hectorsvill/bb1-balance-bot-1/firmware/README.md

# Firmware

| Folder | What it is |
|---|---|
| `bb1/` | The main firmware, grown one step at a time (see `docs/FIRMWARE_PLAN.md`) |
| `motor_test/`, `imu_test/`, `tof_test/` | Bring-up tests, kept as they were |
| `uf2/` | Prebuilt files to drag onto the Pico |

## RAM (firmware 3.3, 2026-10-28)

The RP2040 has 256 KB of main RAM. Static RAM (fixed at compile time) is 218.0 KB (was 226.0 KB in 3.2); what's left, about 44 KB, is the heap (Strings, web requests, Wi-Fi connections). Where the static part goes:

| What | Bytes | Whose |
|---|---|---|
| Log ring buffer (`telemetry.h`): 2000 records x 72 bytes = the last 10 s | 144,000 | ours |
| lwIP TCP/IP stack: packet pool 36.8 KB, its own heap 16 KB, connections, DNS, DHCP | 58,400 | core (prebuilt, "IPv4 Only" is already its smallest setting) |
| Code that must run from RAM, malloc, locale | 6,000 | core |
| CYW43 Wi-Fi chip driver and `WiFi` | 3,200 | core |
| USB serial, other core variables | 5,500 | core |
| Everything else of ours (`server`, settings, controller state) | 600 | ours |

- **3.3:** the buffer no longer stores the tick number (record n in the buffer is always tick n, so `logGet()` puts it back). 76 -> 72 bytes a record, 8,000 bytes saved, the CSV is exactly the same.
- The log buffer is the only big thing we own. The next step down is a shorter history (`LOG_SECONDS` in `config.h`): 8 s saves 28.8 KB more, 6 s saves 57.6 KB. The cost: a recorder (page, `logger.py`, `drive_test.py`) that doesn't ask for `/log` for longer than that loses records (they poll every 0.25 s; the worst Wi-Fi stall seen is 2.5 s). Not changed yet: a choice for us to make.
- Big stack buffers on core 0 (`/state` 1.4 KB, `/log` 2 KB) are not in these numbers: core 0 has its own 4 KB stack. Keep new ones small.
- Check **Heap free** in the Pico memory panel (or `GET /sys`) stays over 20 KB.

## Firmware updates over Wi-Fi (`ota.h`, 2026-10-27, flashed)

`POST /update` takes a new firmware over Wi-Fi; `tools/flash.py --ota --execute` sends it (without `--execute`, flash.py only prints a JSON plan). Lying down and disarmed only (BB1 checks), password `BB1_OTA_PASSWORD` in `secrets.h`. Needs Flash Size "Sketch: 1MB, FS: 1MB" (`flash.py` and CI use it; the first one goes on over USB). How it works and what to do when it fails: `docs/FLASHING.md`, "Flashing over Wi-Fi".

`version.h` says which firmware this is: `FIRMWARE_VERSION` (bump it by hand per firmware change) and `BB1_BUILD_ID` (written by `flash.py` into the gitignored `build_id.h`). Shown in `/sys`, `/api`, the main page and the log files.

## bb1, milestone 2: driving (`drive.h`, 2026-10-25; changes of 2026-10-26 flashed)

BB1 drives by moving the **targets** of the speed loop and heading hold, never by sending PWM straight to the wheels, so the balance loop stays in charge (quad picture: angle mode with position hold, and the sticks move the hold point).

- Speed: the speed loop now works on `speed - asked speed` and `position - target position`. While driving, the target position rides with the wheels; when BB1 comes to a stop it holds that spot (and that heading). Lean forward to speed up, back to slow down: the loop works it out.
- Turn: the heading hold's target (right-minus-left wheel turns) slides at the asked turn rate, and `DRIVE_TURN_FF` (15 PWM per turn/s) adds the steering at once, like Betaflight feedforward, so the hold doesn't have to lag first. Limited to ±100 PWM (`TURN_HOLD_MAX_PWM`; ±40 before firmware 3.7). (45 was tried 2026-10-26 from a misread log and overshot.) **Known bug:** the logged wheel speed reads 3.3x low (CHANGELOG 2026-10-26).
- Speed feedforward, setting **`dff`** (PWM per turn/s of speed target, default 60, /tune box **Drive FF (dff)**, serial `dff 60`, saved in flash, settings layout v5): added straight to both wheels. Why (first drive log, 2026-10-25): these motors are speed knobs, holding 1 turn/s takes about 105 PWM, and without feedforward the angle I term carried all of it (I about +100 going forward). Reversing, I had to unwind from +100 while the wheels kept rolling forward, BB1 tipped back past 9 deg, hit the cap and fell backward: every fall in that log. Feedforward takes most of that load off I.
- Both ramp (speed at setting **`dacc`**, default 3 turns/s per s since 2026-10-29, was the constant `DRIVE_ACCEL`; turn at 6, 2 before firmware 3.7): a full jab can't kick it over. Limits ±3 turns/s speed (`DRIVE_MAX_SPEED`, 1.0 before firmware 3.6) and ±5 turns/s turn (`DRIVE_MAX_TURN`, 1.0 before 3.7; one spin = 4.49); the lift detector trips at 4 turns/s off the target. Slowing down is never slower than 3 turns/s per s (`DRIVE_STOP_ACCEL_MIN`).
- Failsafe: a command lasts 500 ms (`DRIVE_HOLD_MS`, or `ms=` up to 3000). Not sent again = ramp to a stop and keep balancing. Disarm, fall or a new arm clears it. While turning, the heading target never gets more than 0.25 wheel turns (about 18 deg) ahead of the wheels (`DRIVE_MAX_LAG`; was 1.0, which made BB1 swing 35-90 deg after a turn and roll 2-3 turns after letting go, floor test 1).
- Each axis only lets go of its own hold (2026-10-26): turning on the spot keeps the position hold (it rolled back 1-2 wheel turns per turn test), and driving straight keeps the full heading hold (the 0.25-turn lag clamp applies only while turning).
- `driveCommand()` in `drive.h` is the one place that clamps a command and hands it to core 1, for both `POST /drive` and serial `drive`; non-numbers (`nan`) are refused (HTTP 400). An encoder fault also ends the command already running.
- **Exact-angle spins (firmware 3.10):** `POST /spin deg=90 rate=2`, serial `spin 90 [rate]`, page Spin buttons. `spinCommand()` clamps and hands it over like `driveCommand()`; `spinUpdate()` (core 1) subtracts the gyro yaw (`angle.h` `yawRate`, right +) from the angle still to go every tick and starts the turn ramp-down when that equals the stopping angle (yaw rate x ramp time / 2). The gyro, not the wheels: they scrub in a spin (gyro / encoder yaw = 0.83, runs 189-190). Any `/drive`, a stop, a disarm, an encoder fault or a timeout ends it. Logged as `spin_left` (log format 14), in a 2-byte padding gap of `LogData`, so the record stays 72 bytes (a `static_assert` guards it).
- Drive speed I, setting **`sdi`** (default 4 since the 2026-10-26 evening drive tests; was 2): while driving, degrees of lean added per second per turn/s it is slower than asked, so it can't get stuck short of the asked speed (it did going forward with the speed loop's P alone). Capped by `SPEED_SHIFT_MAX`, fades out after a stop.
- **Speed loop mode `smode`** (2026-10-26): 0 = the speed loop moves the setpoint (sp, si, sdi). 1 = wheel speed loop: `wsp` x speed error + `wsi` x position error straight to the PWM (±100), the balance-car layout, for use with a lower ki. Why: with smode 0 the angle I term holds the wheel speed and the speed loop can't reach it (BB1 rolled backward with no command).
- **I-term relax `irelax`** (2026-10-26, default 0.5 s, 0 = off): when a drive command has ramped down to a stop, the angle loop's I term decays toward 0 with that time constant for 2 x irelax (`drive.h` starts it, `control.h` does it, flag 64 in the log). Why: after driving the I term kept -4 to -9 PWM and rolled BB1 slowly backward, out of the box in unattended runs. Like Betaflight's I-term relax. Driving again cancels it. Live on /tune, serial `irelax N`, `/state`, saved in flash (settings layout v8; older saves get the default).
- **Fast drive step 1 (firmware 3.4, 2026-10-28): `aff`, `dacc`, `lmax`**, all live on /tune and serial, saved in flash (settings layout v9; older saves load with the defaults), in `/state` gains and the `# gains_ver` line (`accel_ff`, `drive_accel`, `lean_max`). Defaults = the old behavior. Why: at 0.5 turns/s on wood BB1 used about 24 of 200 PWM and leaned under 1 deg; the lean only came after a speed error built up, so it lagged and fell short. To accelerate at a, a balancing robot must lean atan(a/g): 1 turn/s² = 0.178 m/s² = about 1.04 deg.
  - `aff` (deg per turn/s², default 0 = off, max 5): acceleration lean feedforward. `drive.h` works out the ramped target's acceleration each tick (+dacc, -dacc or 0), smooths `aff x accel` over 0.05 s (`ACCEL_FF_SMOOTH_S`), and `control.h` adds it to the speed loop's setpoint shift (smode 0 only). Like Betaflight feedforward: lean before the error exists.
  - `dacc` (turns/s per s, default 1, 0.1-6): the speed ramp. The turn ramp is unchanged.
  - `lmax` (deg, default 6, 6-15): the clamp on the setpoint shift (and on the `sdi` lean) while a speed target is set or ramping down. Standing it is `SPEED_SHIFT_MAX` (6). Raising the clamp is instant (it only allows more); lowering eases at 10 deg/s (`LEAN_LIMIT_EASE_DPS`), so the setpoint never jumps (a 4 deg jump would be a 72 PWM kick at kp 18).
  - `DRIVE_MAX_SPEED` stays 1.0 (step 2 below).
- **Fast drive step 2 (firmware 3.6, 2026-10-29): top speed 3.0 turns/s** (0.53 m/s; `DRIVE_MAX_SPEED`, was 1.0; turn stays 1.0). Why it is safe to try: at 1.0 on wood the PWM peaked at 102-106 of cap 200, never saturated, and steady driving takes about dff 25 PWM per turn/s + deadband 10, so 3.0 needs about 85 PWM before balancing. In the same change:
  - **Log format 12:** `drive_speed`, `drive_turn`, `drive_speed_now`, `drive_turn_now` are int8 in 1/40 turns/s (`DRIVE_LOG_STEPS`, telemetry.h; max 3.17, steps 0.025) instead of hundredths (max 1.27). No RAM cost; int16 would have been 8 KB. The CSV still says turns/s (3 decimals). Flag 8 (saturated) now also counts the PID + feedforward + deadband at the cap.
  - **Lift detector** compares each wheel with its drive target (`control.h`): standing still it is the old check, driving fast it doesn't trip.
  - **Speed guards** (`drive.h` `speedCeiling()`): the feedforward `dff x speed` never takes more than `cap - DRIVE_PWM_RESERVE` (80) PWM, and if the motor PWM sits at the cap more than 0.2 s while driving (`DRIVE_SAT_BACKOFF_S`), the speed target backs off at 3 turns/s per s and climbs back at `dacc`. Why: a balance loop at the cap can't catch a fall. `/state` `speed_now` shows the result.
  - **Stops:** slowing down is never slower than `DRIVE_STOP_ACCEL_MIN` (3 turns/s per s), so a run-out command or `/drive/stop` from 3 turns/s stops in 1 s (about 0.27 m) even at a low `dacc`.
  - The `# drive_max_speed` header line also gives `drive_pwm_reserve`, `drive_sat_backoff_s`, `drive_stop_accel_min`, `lift_tps`, `lift_ms`. `/api` version 6. The page's Max speed slider is in turns/s (default 1.0, up to 3.0).
  - Tests: wood, fwd-back-100 forward 1.00 / back 0.77, fwd-back-150 back 1.42, PWM peak 135, no saturation (runs 177, 179). Carpet stalls forward (0.06-0.13 of 1.0) on the 2 Hz balance rocking (runs 175-176).
- **Fast spins (firmware 3.7, 2026-10-31): turn 5.0 turns/s**, a full 360 on the spot in about 1 s (it was 4.5 s at 1.0). In the same change:
  - **Deadband per wheel** (`control.h` `wheelPwm()`, called in `bb1.ino`): the deadband is added to each wheel after the steering, in the direction that wheel turns. Before, it was added once to the shared balance output, which crosses 0 about 11 times a second, so both wheels jumped by 2 x deadband each time and the slow wheel of a turn stuck and slipped: the turn jitter (run 178). It also steadied standing (pitch std 0.60 -> 0.23 deg).
  - **Steering** up to ±100 PWM (`TURN_HOLD_MAX_PWM`, was 40), turn ramp 6 turns/s per s (`DRIVE_TURN_ACCEL`, was 2).
  - **Pitch while turning** (`angle.h`): the chip sits about 2.5 deg off level, so it sees part of the yaw rate as pitch rate: `pitchRate += GYRO_YAW_TO_PITCH (0.043) x gz`. Without it, a turn-2 spin read 6 deg/s of fake tilt and BB1 raced backward (run 181). A gyro-only mode above 120 deg/s and an accelerometer centripetal correction were tried and taken out: the correction was fitted on a run where BB1 really tilted and made long left spins roll back (run 186); the accelerometer moves only 0-1 deg in a spin.
  - **Log format 13:** `drive_turn` and `drive_turn_now` in 1/20 turns/s (`DRIVE_TURN_LOG_STEPS`, max 6.35). `/api` version 7. Tests: `drive_test.py spin-100` ... `spin-450` (runs 182-185, all pass).
- **Trim learn `tl` (firmware 3.5, 2026-10-29; default 1.0, 0-5, 0 = off):** the fix for the backward creep after stops. Why: on wood BB1 really balances about +1.3 deg forward of `trim`; the speed loop's position term (si) would cancel that, but `drive.h` moves its hold point to the wheels at every stop, so after each command BB1 got the lean it needs only from `-sp x speed`, by rolling backward at 0.2-0.4 turns/s. `control.h` now keeps `balance.trimLearned` (deg, ±3 at most, `TRIM_LEARN_MAX`): in smode 0, while armed and standing still (both ramps at 0, not stopping, the coast and I relax after a stop over, no step test), each wheel turn rolled moves it `tl` deg the other way. It is added to the setpoint shift and never reset except at boot (or tl 0): an I term on position that remembers the trim error across drives. Live on /tune (box and Live "Learned trim"), serial `tl N`, `/state` `trim_learned` and gains `tl`, saved in flash (settings layout v10), `# gains_ver` line `trim_learn`.
- How to send it: the **Drive** panel on http://bb1.local, `POST /drive` (docs/API.md), or serial `drive 0.3 0 2000` / `drive stop`.
- Log format 9: `drive_speed`, `drive_turn` (the operator command), flag 16 = stopping. Log format 10 (2026-10-26): `speed_l`/`speed_r` fixed, they read 3.3x low before (`constrain()` macro called `update()` 3 times a tick). Record was 76 bytes, static RAM 225.6 KB (heap about 36 KB); since firmware 3.3 see "RAM" below.

## Encoder fault detector (`control.h`, 2026-10-25)

Both wheels should read about the same speed going straight. If one reads under 20% of the other while that one does over 500 counts/s (150 before the 2026-10-26 speed fix: the same real speed), for 0.3 s and with no turn asked (`ENC_FAULT_*` in config.h), that encoder is not counting (found when the left one stopped counting backward: a loose wire). Bad counts make the heading hold spin BB1 in circles, so while faulted: heading hold off, driving refused (409 / serial message), log flag 32, `/state` `enc_fault` (1 left, 2 right), warning on the page. Cleared by the next arm. Quick check: motor test `m -80 -80 1000` with the wheels in the air; both "moved" counts should be about −1400.

## bb1, step 7: save settings + step test

- **Save to flash** (page Balance panel, or `save` on serial) stores Kp, Ki, Kd, trim, cap and deadband in the Pico's flash (`settings.h`, next to the Wi-Fi settings). They load at startup, so a restart keeps your tuning. Only while disarmed. **Defaults** (`defaults`) goes back to `config.h`, which now starts at trim −4.39 and cap 80.
- **Step test** (page button or `step`, armed only): the setpoint jumps +2 deg for 1 s, then back. Record it: the `setpoint` column shows the step and `pitch` shows how the loop follows. Used to compare gains (docs/PID_TUNING.md).

Checked on the robot: saved kd 0.6, restarted, it came back as 0.6; the flash write caused 0 missing ticks and 0 overruns.

## Auto-arm (`auto_arm.h`, reworked and flashed 2026-10-24)

BB1 starts balancing by itself. Switched on standing up, it balances about 3.5 s later (2 s gyro calibration, then 1 s held upright). Switched on lying down, it waits until you stand it up and hold it still for 1 s. Every edge case: [docs/POWER_ON.md](../docs/POWER_ON.md).

- `auto_arm.h` is a small state machine: `OFF_SETTING`, `OFF_STOPPED`, `OFF_FALLS`, `NO_IMU`, `WAIT_UPRIGHT`, `HOLDING`, `BALANCING`. The state is printed on serial when it changes (`auto-arm: ...`), shown on both pages next to the mode, and logged every tick (`auto_state`, log format 8).
- **STOP always wins:** STOP / Enter / the arm timer / a Wi-Fi drop / IMU errors / a low battery turn auto-arm off until the next ARM or power-up.
- After a fall it re-arms when stood up, but **3 falls within 30 s** turn it off until ARM.
- **Lift detector** (`control.h`, any arm): wheels over 4 turns/s off their drive target (since 3.6; standing still the target is 0) for 0.5 s = picked up, motors off, reason "picked up". Stand it back on the floor and it re-arms. It could never trip before the 2026-10-26 speed fix (the speed read 3.3x low).
- Battery under `BATTERY_LOW_V` (6.6 V, and a reading is present): it won't auto-arm, `balanceArm()` refuses, and if it is already balancing `balanceTick()` disarms (`REASON_BATTERY` = 13, motors off). No sense wire (under `BATTERY_MIN_SENSE_V`): no battery check. A motor test also blocks auto-arm.
- No script or page needed: `handheld.py` and /tune are for testing. The main page's **ARM** / **STOP** match serial `arm` / `disarm` (ARM there sends `heartbeat=0`: no timer, keeps going if the page closes).
- Setting `auto` (1 / 0): serial `auto 0`, /tune box **Auto-arm (1/0)**, saved in flash. Constants in `config.h` (`AUTO_ARM_*`, `AUTO_MAX_FALLS`, `AUTO_FALL_WINDOW_MS`, `LIFT_*`).

## Heading hold (2026-10-24, flashed)

BB1 curved left: the right wheel turns about 7% faster at the same PWM. `balanceSteer()` in `control.h` compares how far each wheel rolled since arming and moves PWM from the wheel that's ahead to the other: `steer = th x (right turns - left turns)`, left gets `+steer`, right `-steer`, limited to ±40 PWM. Setting `th` (serial `th 20`, /tune box **Heading (th)**, saved in flash, settings layout v3; older saved settings still load with it off). Default 0 = off. In the log, `pwm_l - pwm_r` = 2 x the steering. The same idea will steer BB1 in milestone 2 (driving).

## bb1, step 8: speed loop (2026-10-24, flashed)

The angle loop alone holds BB1 at the trim angle, but any small trim error is a steady lean, and a steady lean means accelerating that way forever: it rolls faster and faster until the motors max out (TUNING_LOG rounds 16 to 20). Step 8 adds an outer loop in `control.h` that watches the wheels and moves the target angle:

```text
target = trim - (sp x wheel turns per second  +  si x wheel turns since arming)    (limited to +-6 deg)
```

- **Speed P (`sp`)**: rolling forward 1 turn/s leans the target back `sp` degrees, so the angle loop runs the wheels ahead of the body, BB1 tips back and brakes.
- **Speed I (`si`)**: the integral of speed is position. Rolled 1 turn forward since arming leans the target back `si` degrees: pulls it home and cancels a trim error.
- Both default to **0 = off** (the angle loop alone, as before). Set them on /tune (boxes **Speed P (sp)**, **Speed I (si)**) or serial `sp 1.5`, `si 0.5`. Saved to flash with the others (settings layout v2; settings saved before step 8 still load, with the speed loop off).
- Wheel speed is smoothed (`SPEED_FILTER`, about 0.1 s) so encoder steps don't kick the angle loop.
- The log's `setpoint` column shows the moving target (trim + shift); the header's gains line has `speed_p` / `speed_i`.

Battery voltage (2026-10-24, **flashed**; together with the clean-up and the 2 s heartbeat below): `battery.h` reads the D153C's `ADC` pin (battery / 11) on GP26 from core 0 every 100 ms. Shown as a chip on both pages, in the serial readout (`batt 7.92 V`) and `/state`; every log row gets `batt_v` (log format 6, record now 72 bytes, RAM free 44 KB).

Clean-up (2026-10-23, flashed 2026-10-24): the balance settings' names and limits live in one place, `setBalanceSetting()` in `settings.h` (serial, `/gains` and loading from flash all use it); limits in `config.h` (`GAIN_P_MAX` etc.).

Tuning page (2026-10-21): **http://bb1.local/tune** changes Kp, Ki, Kd, trim and cap live and shows only pitch, error, P / I / D and PWM (`tune_page.h`). Since 2026-10-23 it also has ARM (with a timer) and STOP, for runs with no USB cable; log with `handheld.py --wifi`. A change from any page now also prints a `gains` line on serial. Both ways to change gains (page, or `config.h` + `defaults`): `docs/PID_TUNING.md`.

Fix (2026-10-21): the web server now closes each connection after answering (`route()` in `web.h`). Before, one connection the browser left open froze the server for up to 5 s and armed runs disarmed with "lost the web page".

### Hand-held test, the current way: serial + logger.py (no web page)

Why not the page: arming from the page ties the motors to Wi-Fi (no `/state` for 1 s = disarm), and Wi-Fi hiccups kept cutting the test short. For getting BB1 to balance we leave the page closed: you arm from **serial** over the USB cable (no heartbeat check then) and **logger.py** records over Wi-Fi in the background. If Wi-Fi stalls, the robot keeps the last 10 s, so the logger catches up without losing records. All other cut-outs still work: the arm timer, 45 deg (FALLEN), low battery, IMU errors, late loops, Enter.

**Before you start**
1. Plug in USB (battery on or off: the diode makes the order safe).
2. Close every BB1 page tab (phone too), and any serial monitor (only one program can hold the USB port).
3. Fingers clear of the wheels. Hold the frame, wheels in the air.

**Start the test tool** (from the repo folder). It talks to BB1 over USB and records the log over Wi-Fi at the same time:

```bash
tools/venv/bin/python tools/handheld.py
```

It prints the gains first: check kp 15, kd 0.5, trim about −3.98, cap 80. The bottom line shows the pitch, how far you are from the trim, and how much has been logged. Keys (no Enter needed): **a** = arm 5 s, **Enter** or **space** = disarm now, **g** = gains, **q** = save the log and quit.

**The test**
1. Hold BB1 at its balance point (status line near 0 from trim) and press **a**. You see `ARMED`. It disarms by itself after 5 s.
2. Tilt a little forward ("hectorsvill" side down): both wheels roll **forward**, harder with more tilt.
3. Tilt a little back: both roll **backward**.
4. Wrong way round? Press **Enter** at once and tell me.
5. Press **a** again, then tilt past 45 deg: `DISARMED: fell over (leaned past 45 deg)`. If it says `arm time finished`, you were slower than 5 s: try again.

**After**
1. Press **q**. It disarms, saves `logs/bb1_<date>_<time>_handheld.csv` and prints a `check_dump.py ... --plot` line: run it. Missing ticks should be 0.
2. Send me the file name and tell me what the wheels did.

**Result 2026-10-21: passed.** Wheels roll toward the lean both ways and the 45 deg cut-out works (numbers in docs/BUILD_RECORD.md).

### First floor attempts (next)

Why on the floor now: in the air nothing pushes back, so you only learn the directions. On the floor the wheels have to catch the fall, which is what the gains are for. Expect it to fall a lot at first: that's how you find the right Kp.

1. Something soft around it (a towel or cushions), clear space in front and behind.
2. Start the tool with a longer arm time: `tools/venv/bin/python tools/handheld.py -s 10 -n "floor kp15"`.
3. Hold BB1 upright on the floor, hands loosely either side (not touching), press **a**, let go gently.
4. Watch what it does, then catch it (or let it fall onto the soft stuff; past 45 deg it stops by itself).
5. Change one gain with **:** (for example `kp 20`), try again. The table in docs/PID_TUNING.md, section 4, says which way to go. Write each try in the note (`-n`) or tell me.
6. When a setting is better, type `save` with **:** while disarmed.

**Without the tool** (same test by hand): a serial monitor (`arduino-cli monitor -p /dev/cu.usbmodem21401 -c baudrate=115200`, or the Arduino IDE 2 Serial Monitor at 115200 baud, New Line) plus `tools/venv/bin/python tools/logger.py -t 30 -n "handheld"` in a second terminal. Type `quiet` first to pause the 10 Hz readout, then `gains`, `arm 5`, Enter to disarm.

## bb1, step 6: arm / disarm + the angle loop

The first balance controller (`pid.h`, `control.h`). Boots **disarmed**. **ARM** (page, or `arm` on serial) only works within 10 deg of the trim with the gyro calibrated; then the PID drives both wheels from the lean. It disarms by itself if it leans past 45 deg (FALLEN), the IMU fails 5 ticks running, the loop overruns 5 ticks running, or (armed from the page) the page stops asking for `/state` for 1 s. **DISARM**, STOP, the space bar, serial `disarm` or Enter stop it.

Gains, trim, PWM cap and deadband change live (page **Balance** panel or serial `kp 15`, `kd 0.5`, `trim here`, `cap 80`, `gains`). Defaults are in `config.h` (Kp 15, Ki 0, Kd 0.5, cap 150), a guess to start from. Not saved yet (step 7).

Every log row now also has `setpoint, p_term, i_term, d_term, gains_ver` (log format 3), and `mode` 4 = armed, 5 = fallen; flag 8 = output hit the cap.

What to check, **hand-held first** (hold the frame, wheels free, fingers clear of the wheels):
Why: this checks the wheels drive toward the lean (all the signs) and the safety cut-outs before it ever touches the floor. Full explanation: docs/PID_TUNING.md, "The hand-held test". The Balance panel's controls: docs/WEB_INTERFACE.md.

1. Hold it at the balance point, **Use current pitch as trim** (or `trim here`). Write the number down (measured −4.39 deg on 2026-10-21).
2. Set the cap low (`cap 80`), arm time 5 s, **ARM**. Tilt it a little forward: both wheels roll **forward** (toward the lean), harder the more you tilt. Tilt back: they roll backward. If it's the other way round, disarm and tell me (a sign is wrong).
3. Tilt it past 45 deg: it disarms by itself (FALLEN). Close the page while armed: disarms within 1 s.
4. **Record** a run of steps 2 and 3 and check it with `check_dump.py --plot`.
5. Only then on the floor, over something soft, following docs/PID_TUNING.md.

## bb1, step 5: motors + encoders (timed motor test)

Everything from step 4, plus the motors and encoders on core 1 (`motors.h`). Encoders count all the time; the motors only run during a **timed motor test**, which always stops by itself (max 3 s, max PWM 150 of 255; both in `config.h`). STBY stays low the rest of the time. Every log record now also has `enc_l, enc_r, speed_l, speed_r, pwm_l, pwm_r` (log format 2).

**Wheels off the table before any test.**

| Where | How |
|---|---|
| Serial | `m 100 100` (both forward 2 s), `m 0 -80 1000` (right backward 1 s), `stop` or Enter to stop early, `enc` prints both counts |
| Page | **Motor test** panel: left, right, time, **Run**. **STOP** button or the space bar stops it. |
| curl | `curl -X POST -d "left=100&right=100&ms=2000" http://bb1.local/motor` |

When a test ends, serial and the page report how far each wheel moved and the average counts/s.

What to check (wheels in the air):
1. `m 100 100`: both wheels roll **forward**, both counts positive, each about 1,750 counts/s (bring-up value).
2. `m -100 -100`: both backward, both negative.
3. `m 100 0` then `m 0 100`: only the left, then only the right wheel turns.
4. Start `m 100 100 3000` and press Enter (or space on the page) after a second: stops at once.
5. `enc`, turn one wheel exactly one turn forward by hand, `enc` again: the difference is the real counts per turn (520 assumed).
6. **Record** on the page during a test, then `check_dump.py --plot`: the bottom plot shows speed and PWM. Missing ticks 0.

## bb1, step 4: saving logs + live log view (no motors)

Everything from step 3, plus: **Record / Stop / Download** and **Save last 10 s** on the page, a **Live log** panel, a **Pico memory** panel, panels in one column you can reorder with ▲ ▼, and `tools/logger.py` to record from the Mac. New endpoints `/log?since=N`, `/log/meta`, `/sys` (docs/WEB_INTERFACE.md). If the robot is moving at startup, calibration now retries every 3 s until it's still (flag bit 4 in the log until then).

Working on the page without the robot: `tools/venv/bin/python tools/mock_bb1.py`, then http://localhost:8080.

What to check:
1. Page opens at http://bb1.local; Pico memory shows about 150 KB RAM and 420 KB flash used.
2. Live log: press Start, tilt the robot, the `pitch` column (13th) follows. Scroll sideways inside the box.
3. Type a note, **Record** about 20 s of tilting, **Stop**, **Download**. Then:

```bash
tools/venv/bin/python tools/check_dump.py ~/Downloads/<the file>.csv --plot
```

   Missing ticks 0, the plot shows your tilts.
4. **Save last 10 s** right after a tilt: the file has about 2000 records.
5. From the Mac (robot on the home network):

```bash
tools/venv/bin/python tools/logger.py -t 30 -n "logger test"
```

   0 lost, 0 missing ticks, spacing about 5000 us (the web traffic mustn't disturb core 1).

## bb1, step 3: Wi-Fi + web page (no motors)

Everything from step 2, plus the web page. How to connect and what's on it: [docs/WEB_INTERFACE.md](../docs/WEB_INTERFACE.md). New serial commands: `wifi` (network and address), `wifi reset` (forget the home network), `quiet` (pause the readout).

Building on a new machine needs `secrets.h`: `cp firmware/bb1/secrets.example.h firmware/bb1/secrets.h`.

What to check:
1. Serial shows `Wi-Fi: own network "BB1" ... open http://192.168.42.1`.
2. Phone: join **BB1** (the password from your `secrets.h`), open http://192.168.42.1. The page says **connected**; tilting the robot moves the number and the chart.
3. **Calibrate gyro** with the robot lying still: bias updates on the page.
4. Network: save your home Wi-Fi. BB1 restarts and joins it; on your home Wi-Fi, http://bb1.local opens the page. Then **Use own network** brings back "BB1".
5. While the page is open: `dump` still shows 0 missing ticks and 5000 us spacing (the web server mustn't disturb core 1).

## bb1, step 2: two cores + log buffer (no motors)

The control loop (IMU, filter, logging) runs on core 1 at exactly 200 Hz; serial and the readout run on core 0. Every tick is stored in a 10 s ring buffer. Same readout as step 1, plus a `tick` counter and two new commands:

| Command | Does |
|---|---|
| `dump` | print the buffer (about the last 9 s) as CSV |
| `dump N` | print the last N seconds |

What to check:
1. The readout looks like step 1; `tick` goes up by about 20 per line (200 per second).
2. `cal` still works (core 0 asks, core 1 does it, core 0 reports).
3. Tilt it around for a few seconds, then save a dump and check it:

```bash
tools/venv/bin/python tools/serial_log.py -t 5 -s dump -o logs/step2_dump.txt
```

```bash
tools/venv/bin/python tools/check_dump.py logs/step2_dump.txt --plot
```

Missing ticks 0, spacing exactly 5000 us, and the plot shows your tilts.

## bb1, step 1: pitch angle (no motors)

Motors stay off (STBY held low). Flash it, keep the robot still on the table for the first 2 s (gyro calibration), then watch the serial readout.

```bash
arduino-cli compile --fqbn rp2040:rp2040:rpipicow:flash=2097152_1048576 --output-dir build/bb1 firmware/bb1
```

```bash
arduino-cli upload -p /dev/cu.usbmodemXXXX --fqbn rp2040:rp2040:rpipicow:flash=2097152_1048576 firmware/bb1
```

Or drag `uf2/bb1.ino.uf2` onto RPI-RP2. Full flashing steps, power order and troubleshooting: [docs/FLASHING.md](../docs/FLASHING.md). To capture 20 s of output into a file:

```bash
tools/venv/bin/python tools/serial_log.py -t 20 -o step1.txt
```

What calibration does and how to read the output: [docs/CALIBRATION_AND_LOGS.md](../docs/CALIBRATION_AND_LOGS.md).

Commands: `cal` (recalibrate), `alpha N` (filter weight), `csv` (spreadsheet output), `help`.

What to check:
1. At rest: the calibration prints a bias (Y about +2.5 deg/s); pitch sits still (within about 0.2 deg over a minute).
2. Tilt forward about 30 deg: pitch goes **positive**, and `pitch` and `accel only` agree within a degree or two once you stop.
3. While tilting, `rate` is positive going forward. If pitch and accel-only pitch move opposite ways, flip `GYRO_PITCH_SIGN` in `config.h`. If both move together but forward reads negative, flip both signs.
4. Tap the frame: `accel only` jumps, `pitch` barely moves. That's the filter working.
5. `loop avg` well under 5000 us; `overruns` and `imu errors` stay 0.

# Bring-up tests: motors and MPU-6050

Two small Arduino C++ sketches that check each part works before we write the balance code.

| **Sketch** | **Checks** | **Needs the battery?** |
| :-: | :-: | :-: |
| motor_test | Each motor spins both ways through the D153C; each encoder counts | Yes (D153C switch on) |
| imu_test | The MPU-6050 answers on I2C and gives sensible readings | No (USB alone powers the IMU) |
| tof_test | The VL53L0X answers on I2C1 (0x29) and reads distance | No (USB alone powers it) |

Board: Raspberry Pi Pico W with the "Raspberry Pi Pico/RP2040" core by Earle F. Philhower (version 6.3.0 used to compile these).

## Power (1N5819 diode fitted)

Since 2026-10-28 a 1N5819 Schottky diode sits in the D153C 5V to VSYS wire, stripe (cathode) toward the Pico. USB can no longer push 5 V backwards into the D153C's regulator, so USB and the battery can go on and off in any order. USB alone powers only the Pico and the IMU: the motors can't run without the battery.

## Fastest way: drag and drop the ready-made UF2

The `uf2` folder has both sketches already compiled.

1. Prop the robot so both wheels are off the table.
2. Hold the Pico's BOOTSEL button and switch the D153C on, then let go.
3. Plug USB into your Mac. A drive called RPI-RP2 appears.
4. Drag `motor_test.ino.uf2` onto it. The Pico restarts and runs the test.
5. Open a serial monitor: `screen /dev/cu.usbmodem* 115200` (quit with Ctrl-A, then K, then y).

## Learning way: build it yourself with arduino-cli and vim

```
brew install arduino-cli
arduino-cli config init
arduino-cli config add board_manager.additional_urls https://github.com/earlephilhower/arduino-pico/releases/download/global/package_rp2040_index.json
arduino-cli core update-index
arduino-cli core install rp2040:rp2040

vim motor_test/motor_test.ino
arduino-cli compile --fqbn rp2040:rp2040:rpipicow --output-dir build/motor_test motor_test
```

- First upload: put the Pico in BOOTSEL mode (steps 2 and 3 above) and copy the file: `cp build/motor_test/motor_test.ino.uf2 /Volumes/RPI-RP2/`
- After that, while one of these sketches is running: `arduino-cli upload -p /dev/cu.usbmodemXXXX --fqbn rp2040:rp2040:rpipicow motor_test` (find the port with `ls /dev/cu.usbmodem*`)
- Serial monitor: `arduino-cli monitor -p /dev/cu.usbmodemXXXX -c baudrate=115200`

Arduino IDE 2 works too: Settings, Additional boards manager URLs, paste the URL above; Boards Manager, install "Raspberry Pi Pico/RP2040"; pick board "Raspberry Pi Pico W"; Serial Monitor at 115200 with "Newline".

## Test 1: motors (motor_test)

Wheels off the table. Type a command and press Enter:

| **Command** | **What happens** |
| :-: | :-: |
| a+ / a- | Motor A forward / backward for 2 s, then the encoder 1 count |
| b+ / b- | Motor B forward / backward for 2 s, then the encoder 2 count |
| speed N | Set the test speed, 0 to 255 (starts at 100, about 40%) |
| e | Print both encoder counts for 10 s while you turn the wheels by hand |

Write down for each command: which wheel turned, which way it rolled (robot forward or backward), and the count (number and + or - sign). If a motor only hums, try `speed 150`.

## Test 2: MPU-6050 (imu_test)

Flash `imu_test.ino.uf2` the same way. Expect `device at 0x68` and `WHO_AM_I = 0x68`. Sitting still and level, one accel axis reads about 1.00 g and the gyro reads close to 0. Tilt the robot forward slowly and note which tilt angle changes and its sign: that axis becomes our pitch angle.

## Test 3: VL53L0X distance sensor (tof_test, 2026-11-03)

Needs the Pololu library once: `arduino-cli lib install "VL53L0X@1.3.1"`. Compile with the plain board (`rp2040:rp2040:rpipicow`) and flash over USB (it replaces bb1, which has to go back on over USB afterwards: `tools/flash.py --execute`, no `--ota`). It keeps the motor driver asleep (STBY low). Expect `found 0x29` from the I2C1 scan, then a distance in mm about 20 times a second that follows a hand from about 30 mm out to 1-1.2 m; `out of range` past that.
