hectorsvill/bb1-balance-bot-1/docs/API.md

# BB1 HTTP API

Everything the web pages do goes through this API, so anything else (curl, a Python script, an AI agent) can do the same. The code is `firmware/bb1/web.h`; this file is the reference. `tools/mock_bb1.py` answers the same requests with made-up data, so you can try them without the robot.

- **Address:** `http://bb1.local` on the home network, or `http://192.168.42.1` on BB1's own network "BB1". (Some computers don't resolve `bb1.local`; use the IP from `wifi` on serial or the page's status bar.)
- **Style:** plain HTTP. `GET` reads, `POST` does something. Arguments go in the query string or as a form body (`-d name=value`), never JSON. No login: anyone on the same network can drive BB1.
- **One at a time:** the Pico serves one request at a time and closes each connection after answering. Keep requests short and don't open many in parallel. About 20 `/state` a second plus 10 `/drive` a second is what the page uses.
- **Answers:** `/api`, `/state`, `/sys`, `/wifi` (GET), `/drive` and `/spin` answer JSON. Older actions answer one line of plain text meant for a person. Errors use the status code: `400` bad argument, `409` not allowed right now (the text says why), `404` unknown path.
- **Units:** degrees, deg/s, PWM (-255..255, forward +), wheel turns per second (520 encoder counts = 1 turn, assumed). Forward and turn right are positive.

## Every endpoint with curl

Copy-paste versions of every route in `web.h`. Set `B` once per terminal. Use the IP if `bb1.local` is slow (it can time out on macOS). Use `http://localhost:8080` for the mock. **Anything marked "moves" turns the wheels:** check BB1 is on the floor with room to move, or wheels in the air for `/motor`.

```bash
B=http://bb1.local                      # or http://192.168.1.240, http://192.168.42.1, http://localhost:8080

# Reading (safe any time)
curl -s $B/api | python3 -m json.tool   # every endpoint and its limits, JSON (start here)
curl -s $B/state                        # everything now, JSON (also the heartbeat)
curl -s $B/state | python3 -m json.tool # the same, readable
curl -s "$B/log?since=0"                # log records as CSV (up to 1000; ask since=<to> next)
curl -s $B/log/meta                     # the "# setting" lines for the top of a log file
curl -s $B/sys                          # RAM and flash use, JSON
curl -s $B/wifi                         # network mode and saved home network name, JSON
curl -s $B/ -o page.html                # the main page; /tune is the tuning page
curl -s $B/tune -o tune.html

# Balancing (moves)
curl -X POST $B/arm -d seconds=0 -d heartbeat=0   # balance, no time limit, no /state polls needed
curl -X POST $B/arm -d seconds=10                 # balance 10 s; disarms after 2 s without a /state poll
curl -X POST $B/disarm                            # stop balancing: motors off, hold BB1 first
curl -X POST $B/motor/stop                        # STOP: end a motor test and disarm
curl -X POST $B/step                              # step test while armed: setpoint +2 deg for 1 s

# Driving (moves, only while armed)
curl -X POST $B/drive -d speed=0.3 -d ms=2000     # forward 0.3 wheel turns/s for 2 s
curl -X POST $B/drive -d turn=0.5 -d ms=1000      # turn right on the spot for 1 s
curl -X POST $B/drive -d speed=-0.3 -d turn=-0.2  # back and left, 500 ms (the default)
curl -X POST $B/drive/stop                        # ramp to a stop, keep balancing (also ends a spin)
curl -X POST $B/spin -d deg=90                    # turn 90 deg right on the spot, counted by the gyro
curl -X POST $B/spin -d deg=-360 -d rate=4        # a full spin left, faster

# Settings
curl -X POST $B/gains -d sdi=2 -d dff=25          # change any of kp ki kd trim cap deadband sp si th auto dff sdi smode wsp wsi irelax aff dacc lmax tl (RAM only)
curl -X POST $B/gains -d trim=here                # trim = the current pitch
curl -X POST $B/disarm && curl -X POST $B/gains/save   # store the gains in flash (disarmed only: hold BB1)
curl -X POST $B/gains/defaults                    # back to the config.h defaults (save to keep)
curl -X POST $B/alpha -d value=0.98               # angle filter weight, 0.90..0.999
curl -X POST $B/cal                               # recalibrate the gyro: 2 s, keep still, disarms

# Motor test (moves: wheels in the air, disarmed only, stops by itself)
curl -X POST $B/motor -d left=80 -d right=80 -d ms=1000   # PWM up to ±150, at most 3000 ms

# Network (BB1 restarts)
curl -X POST $B/wifi --data-urlencode ssid='MyHome' --data-urlencode password='...'   # join a home network
curl -X POST $B/wifi/forget                       # forget it, back to its own network "BB1"

# Firmware update over Wi-Fi (BB1 restarts; lying down and disarmed only). tools/flash.py --ota --execute does this for you (no --execute = a JSON plan only)
curl -u bb1:<BB1_OTA_PASSWORD> -F firmware=@build/bb1/bb1.ino.bin $B/update
```

Answers: `/state`, `/sys`, `GET /wifi` and `/drive` send JSON. The other actions send one line of text. A `409` says why it wasn't allowed (for example `/gains/save` while armed). Add `-w ' %{http_code}\n'` to see the status code.

## Driving (milestone 2)

BB1 must be balancing (armed). It drives by moving the targets of its speed loop and heading hold (`firmware/bb1/drive.h`), never by sending PWM straight to the wheels, so the balance loop stays in charge.

### `POST /drive`

| Argument | Unit | Default | Limit | Meaning |
|---|---|---|---|---|
| `speed` | wheel turns/s | 0 | ±3.0 (`DRIVE_MAX_SPEED`; 1.0 before firmware 3.6) | forward +, back - |
| `turn` | turns/s of left-minus-right wheel difference | 0 | ±5.0 (`DRIVE_MAX_TURN`; one spin on the spot = 4.49) | right +, left - |
| `ms` | ms | 500 (`DRIVE_HOLD_MS`) | 0..3000 (`DRIVE_HOLD_MAX_MS`) | how long this command lasts |

Out-of-range values are clamped, not refused; the answer says what will actually run:

```json
{"ok":true,"speed":0.50,"turn":0.00,"ms":500}
```

Not balancing: `409` and `{"ok":false,"error":"not balancing: arm first (POST /arm)"}`. Encoder fault (`/state` `enc_fault`): `409` with `"error":"encoder fault: ..."`, and a fault also ends the command already running. `speed` or `turn` not a number (`nan`, `inf`): `400` and `"error":"speed and turn must be numbers"`. Text that doesn't start with a number counts as 0, like Arduino's `toFloat()`.

**The failsafe:** every command runs out. To keep driving, send it again before it does (the page sends every 100 ms). When it runs out, BB1 ramps to a stop and keeps balancing where it is; it does not disarm. So a dropped Wi-Fi, a closed page or a crashed script can never leave BB1 driving for more than `ms`. A single command can ask for up to 3 s, for "drive forward for 2 s" without a loop.

Speed and turn ramp toward what you ask (speed at the setting `dacc`, default 3 turns/s per second; turn at 6 since firmware 3.7, 2 before), so a full jab can't tip it over. Slowing down (a stop, a run-out command, a lower speed) is never slower than 3 turns/s per second (`DRIVE_STOP_ACCEL_MIN`), whatever `dacc` is: from 3 turns/s BB1 stops in 1 s and about 1.5 wheel turns (0.27 m). Disarming, a fall or a new arm clears the command.

Driving needs the speed loop (`sp`, `si`) and heading hold (`th`) on. They are by default (sp 3, si 0.5, th 60). With `th 0` turning still works on feedforward alone (`DRIVE_TURN_FF`, 15 PWM per turn/s), just less exactly. Turning on the spot keeps the position hold, and driving straight keeps the full heading hold (each axis only lets go of its own hold). Speed has an I term while driving, the setting `sdi` (degrees of lean per second for every turn/s it is slower than asked, default 4): without it BB1 stayed stuck going forward, because on wood the angle loop's I term is the real wheel-speed command and the speed loop only moves the setpoint. **`smode 1`** swaps that for a wheel speed loop: speed and position errors go straight to the PWM (`wsp` PWM per turn/s, `wsi` PWM per wheel turn), the classic balance-car layout, meant for use with a lower `ki` (tested 2026-10-26: it drove the wrong way at every ki from 100 to 25 on wood, so it stays off); `smode 0` (default) is the layout above. Speed also has a feedforward, the setting `dff` (PWM per turn/s, default 25): the PWM a speed needs goes straight to the wheels, so the angle loop's I term doesn't have to wind up to it and unwind it when you reverse. When a command has ramped down to a stop, the setting `irelax` (seconds, default 0.5, 0 = off) drains the angle I term toward 0 for 2 x irelax, so the I term can't keep the wheels rolling the old way (it rolled BB1 slowly backward after stops, 2026-10-26).

**Fast drive settings (firmware 3.4, 2026-10-28; defaults = the old behavior).** `dacc` (turns/s per second, 0.1-6, default 1): how fast the speed target ramps. `aff` (deg per turn/s², 0-5, default 0 = off): acceleration lean feedforward; while the speed target ramps, BB1 leans `aff x dacc` deg into it at once (forward when speeding up forward, back when slowing), instead of waiting for a speed error. Physics: 1 turn/s² = 0.178 m/s² needs atan(0.178 / 9.81) = about 1.04 deg of lean, so about 1 is the textbook value. `lmax` (deg, 6-15, default 6): the most the speed loop may shift the balance setpoint while a speed target is set or ramping down; standing still the limit stays 6 (`SPEED_SHIFT_MAX`), and after a stop it eases back down at 10 deg/s, never in one jump. (Defaults since 2026-10-29: `aff` 1, `dacc` 3, `lmax` 8.)

**Fast drive step 2 (firmware 3.6, 2026-10-29).** `drive_max_speed` is 3.0 turns/s (0.53 m/s); `drive_max_turn` stays 1.0. Two guards can lower the speed BB1 really aims for (`/state` `drive.speed_now`) below what you asked (`drive.speed`), both to keep PWM for balancing: the drive feedforward `dff x speed` may use at most `cap - 80` PWM (`DRIVE_PWM_RESERVE`; with dff 25 and cap 200 that is 4.8 turns/s, so only a higher `dff` or a lower `cap` makes it bite), and if the motor PWM sits at the cap for more than 0.2 s while driving (`DRIVE_SAT_BACKOFF_S`), the speed comes down at 3 turns/s per second until it doesn't, then climbs back at `dacc`. The lift detector (disarm reason 12) now compares each wheel with the speed BB1 aims for: it trips when the wheels run more than 4 turns/s off it for 0.5 s, so standing still it is the same as before and driving fast doesn't trip it.

**Fast spins (firmware 3.7, 2026-10-31).** `drive_max_turn` is 5.0 turns/s: a full spin on the spot is 4.49 turns of left-minus-right difference (track 127 mm, 177.8 mm per wheel turn), so turn 5 spins once in about 0.9 s, plus the ramps (6 turns/s per second up and down: from turn 5 it turns on about 2 more wheel-turns of difference, about 170 deg, after the command ends). The steering may use up to 100 PWM (was 40). The IMU sits about 2.5 deg off level, so the pitch rate is corrected by 0.043 x the yaw rate (otherwise a fast spin reads as several deg/s of tilt). The motor deadband is added per wheel after the steering, not to the shared balance output (it made slow turns judder).

**Trim learn (firmware 3.5, 2026-10-29).** `tl` (deg of lean per wheel turn rolled, 0-5, default 1, 0 = off): while BB1 stands still (no drive command, ramps at 0, the coast and I relax after a stop over), every wheel turn it rolls moves its lean target `tl` deg the other way, and it keeps that correction across drives, stops and re-arms until a restart (or `tl=0`, which also clears it). `/state` `trim_learned` shows it (deg, ±3 at most; + = BB1 really balances forward of `trim`). Why: the position hold point (`si`) moves to the wheels at every stop, so a trim error used to come back as a slow backward creep after each command (CHANGELOG 2026-10-29).

### `POST /drive/stop`

Ramp to a stop now and keep balancing. Always allowed. Also ends an exact-angle spin. Answers `{"ok":true,"speed":0,"turn":0,"ms":0}`.

### `POST /spin` (firmware 3.10)

Turn on the spot by an angle. BB1 counts the turn with its gyro and lands on it by itself, so one request is enough and Wi-Fi delays don't change the angle. Same checks as `/drive` (`409` unless balancing, or with an encoder fault).

| Arg | Unit | Default | Limits | Sign |
|---|---|---|---|---|
| `deg` | degrees of real heading | required | at least 5 either way, at most ±1080 (`SPIN_MIN_DEG`, `SPIN_MAX_DEG`) | right +, left - |
| `rate` | turns/s of left-minus-right wheel difference (the `/drive` turn unit) | 2.0 (about 130 deg/s) | 0.3 to 5.0 (0.5 in 3.10) | none (the sign of `deg` sets the way) |

Answers `{"ok":true,"deg":90.0,"rate":2.00,"timeout_ms":3363}`. `/state` `drive.spin_left` counts down to 0 (deg still to go, right +); 0 again = it has landed. A `/drive`, `/drive/stop`, a disarm, an encoder fault or the timeout (twice the planned time + 2 s) ends a spin early: it ramps to a stop wherever it is.

How it lands (`drive.h` `spinUpdate()`): the turn target ramps down at 6 turns/s per second, so from yaw rate w the ramp-down turns about w x (turn / 6) / 2 more degrees. Every tick (200 per second) BB1 compares that with the angle still to go and starts the ramp-down when they meet. It uses the gyro, not the wheels: in a spin the wheels scrub sideways, and the gyro saw only 0.83 of the turn the encoders counted (runs 189-190, 2026-11-03), so a full spin on the spot is about 5.4 turns of wheel difference, not the 4.49 the track width says. The log's `spin_left` column (log format 14) records the angle still to go every tick.

**Settle (firmware 3.11).** Once the turn target has ramped down, the body can still turn on a few degrees (3.10 tests: 0-4 deg, 10 on a fast 90), because the heading hold takes the wheels wherever they are. For up to 1 s after that, BB1 steers back by the gyro: turn = 0.02 x deg off (at most 0.4), until it is within 1.5 deg and turning slower than 15 deg/s (`SPIN_SETTLE_*` in `config.h`; `spin_left` stays non-zero until then).

### Examples

```bash
B=http://bb1.local
curl -X POST $B/arm -d seconds=0 -d heartbeat=0            # balance (if it isn't already)
curl -X POST $B/drive -d speed=0.3 -d ms=2000               # forward slowly for 2 s
curl -X POST $B/drive -d turn=0.5 -d ms=1000                # turn right on the spot for 1 s
curl -X POST $B/drive/stop                                  # stop driving
curl -s $B/state | python3 -c "import json,sys; print(json.load(sys.stdin)['drive'])"
```

Serial has the same command: `drive 0.3 0 2000`, and `drive stop` (or `ds`).

## Reading state

### `GET /state`

The newest values, as one JSON object. The page asks about 20 times a second. Asking also counts as the **heartbeat**: a run armed with `heartbeat` on (the `/tune` page) disarms if nobody asks for 2 s.

| Field | Meaning |
|---|---|
| `have` | false until the first log record exists |
| `tick`, `t_us`, `uptime_s` | record number (200 a second), its time in µs, seconds since boot |
| `mode` | 0 boot, 1 calibrating, 2 running (motors off), 3 motor test, 4 armed (balancing), 5 fallen |
| `flag_bits` | 1 IMU error, 2 loop overran, 4 no gyro calibration yet, 8 PID at the PWM cap, 16 drive command ran out (stopping), 32 encoder fault, 64 I term draining after a drive (`irelax`) |
| `trim_learned` | deg trim learn (`tl`) adds to the setpoint now (+ = forward), ±3 at most; kept across drives, stops and arms, 0 after a restart or `tl=0` (firmware 3.5) |
| `yaw_deg` | heading from the gyro since power-on, deg, right + (firmware 3.11): the body's real rotation, wheel scrub or not. Drifts a few deg a minute (the gyro bias isn't perfect), so subtract two readings close together |
| `enc_fault` | 0 ok; 1 the left encoder, 2 the right one, is not counting while armed (one wheel reads near 0 while the other spins for 0.3 s). Heading hold is off and `/drive` answers 409 until the next arm. Check that encoder's wires |
| `pitch`, `accel_pitch`, `pitch_rate` | deg (forward +), deg from the accelerometer only, deg/s |
| `armed`, `reason`, `auto_state` | balancing or not; why it last stopped or refused (text, empty if none); what auto-arm is doing (text) |
| `arm_attempts`, `arm_ms`, `arm_left_ms`, `step` | arm requests handled; arm timer length and time left (-1 = no timer); step test running |
| `p`, `i`, `d` | the PID terms right now (PWM) |
| `enc_l`, `enc_r`, `speed_l`, `speed_r` | encoder counts since boot, wheel speed in counts/s (forward +) |
| `pwm_l`, `pwm_r` | PWM sent to each motor this tick |
| `drive` | `speed`, `turn`: the command in force (0 when none); `speed_now`, `turn_now`: the ramped targets BB1 aims for; `left_ms`: time left on the command; `commands`: accepted since boot; `max_speed`, `max_turn`: the limits; `spin_left`: deg an exact-angle spin still has to turn (right +, 0 = none, firmware 3.10) |
| `gains` | `ver` (counts every change), `kp`, `ki`, `kd`, `trim`, `cap`, `deadband`, `sp`, `si`, `th`, `auto`, `dff` (drive feedforward), `sdi` (drive speed I), `smode` (speed loop mode), `wsp`, `wsi` (wheel speed loop), `irelax` (I-term relax after a drive, s), `aff` (acceleration lean, deg per turn/s²), `dacc` (speed ramp, turns/s²), `lmax` (lean limit while driving, deg), `tl` (trim learn, deg per wheel turn) |
| `batt_v`, `batt_ok`, `batt_warn_v`, `batt_low_v`, `batt_cells` | whole-pack volts; false = no sense wire; orange and red limits; 2 cells |
| `test_running`, `tests_done`, `test_moved`, `test_ms` | motor test status and the last result |
| `alpha`, `bias`, `calibrations`, `cal_ok`, `ever_cal`, `imu` | angle filter weight; gyro bias x/y/z (deg/s); calibration status; IMU found |
| `wifi_mode`, `wifi_ssid`, `ip` | `home` or `own`, network name, address |

The mock adds `"mock": true`.

### `GET /log?since=N` and `GET /log/meta`

Every 5 ms record from tick `N` on, as CSV (up to 1000 records per request). The first line says what came back; ask `since=<to>` next time:

```text
# from,1200,to,1450,lost,0
tick,t_us,work_us,...,drive_speed,drive_turn
1200,6012345,451,...
```

`/log/meta` gives the `# setting,value` lines that go at the top of a saved log file. Columns are in `docs/CALIBRATION_AND_LOGS.md`. `tools/logger.py` is a ready-made client; `tools/drive_test.py` drives a scripted test with the same calls and records it.

### `GET /api`

The list of every endpoint and its limits, as JSON, so a program or an AI agent can find out what BB1 understands without reading this file. The code is `firmware/bb1/api.h`; the limits are read from `config.h`, so they always match what the firmware enforces.

| Field | Meaning |
|---|---|
| `api` | version of this list; goes up when an endpoint, argument or limit is added (1 = first, 2 = `POST /update`, 3 = `version`, `build_id`, 4 = gains `aff`, `dacc`, `lmax`, 5 = gain `tl` and `/state` `trim_learned`) |
| `firmware`, `version`, `build_id`, `log_format` | firmware name (the mock says `bb1 MOCK`), version and build id (see `GET /sys`), log column version |
| `units` | what `angle`, `speed`, `turn`, `pwm` mean, and `counts_per_rev` |
| `limits` | `drive_max_speed`, `drive_max_turn` (turns/s), `drive_hold_ms` (default command length), `drive_hold_max_ms`, `arm_seconds_max`, `arm_angle` (must be this close to trim to arm, deg), `fall_angle` (deg), `heartbeat_ms`, `motor_test_max_pwm`, `motor_test_max_ms`, `alpha` [min, max], `log_max_per_request` |
| `gains` | each `/gains` setting and its [min, max]; values outside are clamped. `auto` and `smode` are 0 or 1; `trim` also takes `here`; `dacc` starts at 0.1 and `lmax` at 6 |
| `endpoints` | one object per route: `method`, `path`, `args` (names), `answer` (`json`, `text`, `csv`, `html`), `moves` (true = can turn the wheels), `does` |

```json
{"api":6,"firmware":"bb1 milestone 2","version":"3.6","build_id":"ota 1a2b3c4+ 2026-10-29 14:05","log_format":12,
 "limits":{"drive_max_speed":3.00,"drive_hold_ms":500, ...},
 "gains":{"kp":[0.000,100.000], ...},
 "endpoints":[{"method":"POST","path":"/drive","args":["speed","turn","ms"],"answer":"json","moves":true,"does":"..."}, ...]}
```

Adding an endpoint: route it in `web.h`, add a row to `API_ENDPOINTS` in `api.h` (and bump `API_VERSION`), the same row in `tools/mock_bb1.py`, a row here, and an update to `docs/AGENT.md` with its version line set to the new `API_VERSION` (CI checks they match).

### `GET /sys`

RAM and flash use: `ram_total`, `ram_static`, `heap_total`, `heap_used`, `log_buffer`, `flash_total`, `flash_used`, `page`, `cpu_mhz` (bytes, MHz). `fs_total`: bytes of flash kept for an OTA update (1048576; missing = firmware without OTA). `build`: when this firmware was compiled (`"Oct 27 2026 12:41:07"`), (arduino-cli can reuse a cached compile, so it may not change: use `build_id`). `version`: the firmware version (`"3.2"`, `firmware/bb1/version.h`, bumped by hand per firmware change). `build_id`: written by `tools/flash.py` before each compile: branch, git commit, `+` if there were uncommitted changes, and the time (`"ota 1a2b3c4+ 2026-10-27 14:05"`); `"no build id"` when built without flash.py. Both are also in `/api` and every log file's `# firmware_version` line.

## Balancing

| Request | Does |
|---|---|
| `POST /arm` | start balancing. Refused unless within 10 deg of the trim, battery not low, no motor test (`/state` `reason` says why). `seconds=N`: disarm after N s (0 = no limit, max 600). `heartbeat=0`: keep going without `/state` polls (the main page); otherwise it disarms after 2 s without one. Also turns auto-arm back on |
| `POST /disarm` | stop balancing; auto-arm stays off until the next ARM. `why=hidden` records "page hidden" as the reason |
| `POST /motor/stop` | **STOP**: ends a motor test and disarms |
| `POST /step` | step test while armed: setpoint +2 deg for 1 s |

## Settings

| Request | Does |
|---|---|
| `POST /gains` | any of `kp ki kd trim cap deadband sp si th auto dff sdi smode wsp wsi irelax aff dacc lmax tl`; `trim=here` uses the current pitch. Answers the full set as text |
| `POST /gains/save` | store them in flash (disarmed only) |
| `POST /gains/defaults` | back to the `config.h` defaults (save to keep) |
| `POST /alpha` | `value=0.90..0.999`: angle filter weight |
| `POST /cal` | recalibrate the gyro (2 s, keep still; disarms) |

## Tests and network

| Request | Does |
|---|---|
| `POST /motor` | `left`, `right` (PWM ±150), `ms` (max 3000): timed motor test, disarmed only. Wheels off the table |
| `GET /wifi` | network mode and the saved home network name (never the password) |
| `POST /wifi` | `ssid`, `password`: save a home network and restart. Disarmed only (`409` while armed or in a motor test) |
| `POST /wifi/forget` | forget it and restart on the own network. Disarmed only (`409`) |
| `GET /`, `GET /tune` | the main page and the tuning page |
| `GET /api` | every endpoint and its limits, JSON (see above) |
| `POST /update` | new firmware over Wi-Fi (`ota.h`): multipart form field `firmware` = `build/bb1/bb1.ino.bin` (or gzipped), Basic auth user `bb1`, password `BB1_OTA_PASSWORD` from `secrets.h`. Refused (`409`, JSON `error`) while armed, during a motor test, or unless lying down (more than 45 deg from the trim); `401` for a wrong password. On success answers `{"ok":true,"bytes":N,...}` and restarts; the bootloader copies the new firmware in (about 10-20 s until Wi-Fi is back). While it runs, every arm is refused with reason "a firmware update is running" (code 14). A broken-off upload changes nothing |

## Ready for an AI agent? (milestone 3)

**`docs/AGENT.md`** is the manual an agent gets: settings its owner edits, units, the `tools/bb1.py` commands, what every answer and reason means, and the safety rules. It names the `/api` version it was written for; CI (`tools/check_agent_doc.py`) fails when `API_VERSION` changes and it doesn't.

The API is already usable by a script or an agent with plain HTTP: `/state` to see, `/drive` with `ms` to act, and the drive failsafe means a stuck agent can't leave BB1 driving. What the AI-agent milestone would still add (not built yet):

1. **A small client and CLI** (`tools/bb1.py`, **built 2026-10-26**, see `docs/TOOLS.md`): `state`, `arm`, `drive --speed 0.3 --for 2`, `stop`, `disarm`, one JSON line out, exit codes for scripts. An agent can call a CLI or the HTTP API. **MCP server built 2026-10-28** (`tools/bb1_mcp.py`): the same commands as tools (`bb1_state`, `bb1_drive`, ...) plus read-only log lookups, calling `bb1.py` so its checks and command log apply; tested on the mock only so far.
2. **Real-world units:** measured 2026-10-26 (177.8 mm per wheel turn, 127 mm track; `tools/bb1.py` and `docs/AGENT.md` convert with them). Still to do: `speed` in m/s and `turn` in deg/s of heading in the API itself, plus odometry in `/state` (distance and heading since arming).
3. **Machine-readable answers everywhere:** `GET /api` (**built 2026-10-27**) lists every endpoint and its limits, so an agent can discover them. Still to do: the older actions answer human text; add JSON answers (for example with `Accept: application/json`).
4. **Safety for unattended use:** an "agent mode" with a lower speed limit, a maximum distance from where it armed, and maybe a token so only the agent (and you) can drive. Today anyone on the network can.
5. **Events:** a way to know "it fell" or "it stopped" without polling (for example a counter in `/state` an agent can watch, or a WebSocket later).
6. **Sensors that let an agent see:** the HC-SR04 distance (and later the Pi Zero camera) in `/state`, so it can avoid hitting things.
