hectorsvill/bb1-balance-bot-1/docs/FIRMWARE_PLAN.md

# Firmware Plan: balancing + Wi-Fi tuning page

Updated 2026-10-21 with our choices (section 7). Built step by step; see the table in section 6.

Goal for this milestone: BB1 balances by itself, and a web page served by the Pico W shows live data, lets you change the PID gains while it runs, and runs safe test actions. Every run can be logged in a format that could later train a model to drive the bot.

## 1. Tools

### Already installed (checked 2026-10-21)

| Tool | Version | Used for |
|---|---|---|
| arduino-cli | 1.5.1 (Homebrew) | compile and upload |
| arduino-pico core | rp2040:rp2040 6.3.0 | board support; includes WiFi, WebServer, LittleFS, mDNS, AsyncUDP, EEPROM |
| Python | 3.9.6 (macOS system) | serial and log scripts |
| pyserial | 3.5 | reading the Pico over USB |
| screen | system | quick serial monitor |
| git | system | local commits |
| Node | 24.15 | not needed, but handy for testing the web page offline |

A test compile of `imu_test` worked (15% flash, 26% RAM).

### Missing, needed later

| Tool | Needed for | When |
|---|---|---|
| numpy, pandas, matplotlib (in the `tools/venv` virtual environment, see `tools/README.md`) | plotting test logs, step responses | logging step |
| OpenSCAD | only for rebuilding CAD | optional |

No third-party Arduino library is needed: the core already has Wi-Fi, a web server and flash storage. (WebSockets would need a third-party library whose Pico W support is shaky right now, so the plan avoids it.)

### Claude side

Nothing extra to install. The Obsidian skills already present cover the vault notes. No catalog plugin fits Arduino or embedded work today.

## 2. Software shape

One firmware, `firmware/bb1/`, grown one step at a time. The bring-up sketches stay as they are. Each concern lives in its own small file so you can read it on its own:

```text
firmware/bb1/
  bb1.ino          setup() and loop() for both cores, nothing clever
  config.h         pins, signs, loop rate, limits (one place to change numbers)
  imu.h            MPU-6050 registers, read, bias calibration
  angle.h          complementary filter -> pitch and pitch rate
  motors.h         TB6612 driver + encoders (from motor_test)
  pid.h            a small PID class (anti-windup, derivative on measurement)
  control.h        the balance controller, modes and safety checks
  shared.h         the data the two cores pass to each other
  telemetry.h      the log record and the ring buffer that holds the last few seconds
  wifi_setup.h     own network or home network, saved settings
  web.h            web server routes
  api.h            GET /api: every endpoint and its limits, for programs and AI agents
  secrets.h        own-network password (not in git; copy secrets.example.h)
  page.h           the HTML/JS page as one string
  log_meta.h       the "# setting" lines at the top of every log file
tools/             Python helpers, own virtual environment in tools/venv
  requirements.txt
  logger.py        pulls log records from the Pico over Wi-Fi, writes one CSV with settings lines
  mock_bb1.py      pretend BB1 on the Mac for working on the page (check_dump.py --plot plots runs)
```

### Two cores, two jobs

The RP2040 has two cores. We use that to keep the balance loop's timing steady no matter what Wi-Fi is doing.

```text
core 1 (control, 200 Hz, never waits)        core 0 (everything slow)
  read IMU                                     Wi-Fi + web page
  filter -> pitch                              read commands from the page
  read encoders                                serve log records to the page
  PID -> motor PWM                             USB serial commands
  safety checks
          \__ shared state (gains, commands, latest sample) __/
```

Why: a web request can take tens of milliseconds. If that happened inside the balance loop the robot would fall. The Wi-Fi driver runs on core 0, so control goes on core 1.

Data between cores goes through a small struct guarded by a mutex (or a double buffer). Core 1 never blocks on it: if the lock is busy it keeps the old gains for one more tick.

One catch: writing flash (saving gains) pauses the other core. So gains are only saved while the motors are disarmed.

### Loop timing

- 200 Hz control loop (5 ms). Fast enough for a robot this size and leaves lots of spare time.
- MPU-6050 at 400 kHz I2C, gyro +/-500 deg/s (a falling robot can pass 250), accel +/-2 g, the chip's own low-pass filter at about 44 Hz.
- The loop measures its own time each tick; max and average loop time go in the telemetry so we can see if anything is too slow.

## 3. Control design

Built in layers, each tested before the next:

1. **Pitch angle.** Gyro bias measured over 2 s at startup (robot still). Complementary filter: `pitch = 0.98 * (pitch + gyroRate * dt) + 0.02 * accelPitch`. Signs per CLAUDE.md (negate so forward lean is positive; verify gyro X sign).
2. **Angle loop (PD, then PID).** `pwm = Kp * error + Ki * integral + Kd * pitchRate`, where `error = pitch - setpoint` (forward lean = positive error, positive PWM drives the wheels forward under it; as built in `control.h`). Derivative uses the gyro rate directly, which is cleaner than differentiating the angle.
3. **Speed loop (PI) on the encoders.** Wheel speed error tilts the angle setpoint a little, so the robot stops drifting and can drive. This is the standard cascade for balancing robots.
4. **Turning.** Add `+turn` to one wheel and `-turn` to the other.

Plus a deadband compensation (motors don't move below some PWM) and a balance-point trim (the angle where the robot is truly balanced is rarely exactly 0).

### Modes

`DISARMED` -> `ARMED` (motors live, PID running) -> `FALLEN` (auto stop). Test modes run from the page or serial: `MOTOR_TEST`, `STEP_TEST`.

### Safety (always on)

- Boots `DISARMED`. Arming needs a button press **and** the robot near upright (|pitch| < 10 deg).
- Auto-disarm if |pitch| > 45 deg (fallen), the IMU read fails, the loop overruns repeatedly, or, when armed over Wi-Fi, nobody asks for `/state` for 2 s (`HEARTBEAT_MS`; planned as 0.5 s, built as 1 s, 2 s since 2026-10-23).
- PWM capped (starts at 150/255, raise later).
- Every test action has a fixed time limit and stops itself.
- STBY pin LOW whenever disarmed.
- Wi-Fi password not in git (`secrets.h` in `.gitignore`).

## 4. Wi-Fi: own network or home network

Both are built in, chosen by a setting on the page:

| Mode | How you connect | Page address |
|---|---|---|
| **Own network** (default) | join the Wi-Fi "BB1" from your phone or Mac | `http://192.168.42.1` |
| **Home network** | robot joins your Wi-Fi; its own network turns off | `http://bb1.local` (or the IP it prints on serial) |

- The page has a **Network** panel: type your home Wi-Fi name and password, press Save. The robot restarts and joins it.
- **Settings persist.** They're saved in the Pico's flash through the `EEPROM` library (a small area at the end of flash; the default board setting has no LittleFS area), so they survive power-off and re-flashing. Erasing the whole flash would clear them.
- **Can't lock yourself out:** if the home network isn't found within 15 s at boot, the robot falls back to its own network so you can fix the settings. A serial command `wifi reset` also clears them.
- Settings are only saved while the motors are disarmed (flash writes pause the other core).
- The home Wi-Fi password is stored in plain text on the Pico's flash. It never goes in git.

## 5. The web page

Served by the Pico W itself, one page, no internet needed (no CDN libraries, the chart is drawn by hand on a `<canvas>`, so it works when your phone is on the robot's own network).

- **Live:** pitch, pitch rate, wheel speeds, motor PWM, P/I/D terms, loop time, mode. Scrolling chart of the last 10 s.
- **Tune:** sliders + number boxes for Kp, Ki, Kd, speed-loop gains, balance trim, PWM cap. Changes apply on the next tick. Save to flash (only when disarmed) / load defaults.
- **Actions:** Arm / Disarm (big red button, also the space bar), motor test (each wheel, timed), step test (angle setpoint +2 deg for 1 s, to see the response), calibrate gyro.
- **Log:** Record / Stop / Download (see section 6).
- **Network:** own network or home network (section 4).
- **Drive (milestone 2):** a joystick pad for forward/back and turn.

How it talks: the page polls `GET /state` (JSON) about 20 times a second and sends `POST /set` for changes. Simple, works with the core's built-in WebServer, easy to read.

## 6. Logging (and data for a model later)

The Pico keeps every control tick (200 per second) in a **ring buffer** in RAM: the newest few seconds, oldest overwritten. Anything can pull records out of it over Wi-Fi with `GET /log?since=<tick>`, which returns every record newer than that tick.

Two ways to save a run, using that same endpoint:

| Way | How | Good for |
|---|---|---|
| **In the browser** | press Record on the page; it pulls new records every 100 ms and keeps them in memory. Press Stop, then Download: you get `bb1_<date>_<time>.csv` with the settings as `#` lines at the top. Works on the Mac or a phone. | quick looks |
| **On the Mac with `tools/handheld.py` or `tools/logger.py`** | they pull the same records and write `logs/bb1_<date>_<time>_<note>.csv` (handheld.py also arms and disarms) | tuning runs and building a training set |

Both write the **same CSV columns**, so every analysis or training script reads either. The buffer holds about 10 s, so a short Wi-Fi hiccup loses nothing. Because the robot always keeps the last 10 s, the page also has **"Save last 10 s"**: press it right after a fall, even if you weren't recording.

Each record is one control tick:

| Group | Fields |
|---|---|
| Time | tick number, microseconds since boot, loop time |
| Raw sensors | accel x/y/z, gyro x/y/z (raw counts), encoder counts L/R |
| Estimates | pitch, pitch rate, accel-only pitch, wheel speeds L/R |
| Commands (the "actions") | operator throttle and turn from the page, angle setpoint |
| Controller | error, P, I, D terms, PWM L/R actually sent |
| Context | mode, gains version number, flags (saturated, fallen) |

As built in step 4, the settings go in `# setting` lines at the top of the same CSV instead of a separate `.json` (one file per run, and the serial `dump` already worked that way): firmware, log format, bias, alpha, scales, signs, the note you type, the time and record count. Gains are added when the PID arrives.

Why this works for training later: each row has what the robot sensed (observation), what was asked of it (operator command), and what it did (PWM). That's the standard shape for imitation learning (learn the driving from your remote-control runs in milestone 2) or for fitting a model of the robot's physics. Raw sensor values are kept, not just filtered ones, so a future model isn't stuck with today's filter. Tick numbers make any missing rows show up as gaps instead of silent errors.

### Data for training: status and rules (checked 2026-10-23)

What a model needs, and where it is in our logs:

| Needed | In the logs? | Where |
|---|---|---|
| What BB1 sensed (observation) | yes | raw IMU, pitch, pitch rate, accel pitch, encoders, wheel speeds, every 5 ms |
| What it did (action) | yes | `pwm_l`, `pwm_r` (after the cap and deadband) |
| What it was trying to do | yes | `setpoint` (trim + speed loop shift), and the operator's drive command `drive_speed`, `drive_turn` (log format 9, milestone 2) |
| Which controller made the action | yes | `gains_ver` per row + one `# gains_vN,...` line per version (handheld.py and logger.py; the page's Download only has the gains at the start) |
| Outcome of each try | yes | `mode` (armed / fallen), `reason` (timer, fell, you, Wi-Fi lost...) |
| Conditions | partly | `# surface` and `# note` lines (use `--surface` and `-n`); `batt_v` every row (log format 6, 2026-10-24; D153C `ADC` pin to GP26) |
| Clean vs hand-helped tries | by rule only | press STOP before touching it, so hand help ends the try as "you" |
| Gaps / Wi-Fi trouble | yes | `tick` gaps, `# records,...,lost`, `web_age_ms` |

**Rules for every run** (so the data stays usable):
1. Record with `handheld.py` or `logger.py`, always with `--surface` and a `-n` note (gains, battery voltage).
2. Hands off while armed. To save it, **STOP first**, then catch.
3. Keep every log, falls included: falls teach a model what not to do.
4. Never mix mock logs (`firmware,bb1 MOCK`) into real data.
5. When firmware adds a column: new field at the end of `LogData` (`telemetry.h`), bump `LOG_FORMAT`, add it to `docs/CALIBRATION_AND_LOGS.md`.

**Backup:** done 2026-10-26: `logs/` lives in the private GitHub repo `bb1-private` (290 MB, 159 files) and the public repo's `logs/` is a link to it. **Still to do:**  maybe a "hand touched" event key in handheld.py.

### Training set: checked on the real logs (2026-10-26, `tools/dataset.py`)

Every format-9 row has the observation (raw IMU, pitch, pitch rate, encoders, speeds), the operator action (`drive_speed`, `drive_turn`), the controller output (`pwm_l`, `pwm_r`, setpoint, P/I/D) and the context (`gains_ver` with its `# gains_vN` line, surface, note, `batt_v`, reason, flags). No empty cells. `dataset.py` writes them as one table with outcome labels. First build: 316k rows (26 min) from 20 logs, 58 older logs skipped (format under 9).

What is still missing, smallest fix first:

| Gap | Why it matters | Smallest fix |
|---|---|---|
| Very little driving: 100 s of rows with a drive command, all from `drive_test.py`; 77% of rows are one idle carpet run | a model learns what's in the data | record page-pad driving with `logger.py --surface wood -n ...` running; vary surfaces (tooling only) |
| The ramped targets BB1 really aims for weren't in the log | a model of the controller can't see its own state; the dff part of the PWM can't be rebuilt from the log | done (log format 11): `drive_speed_now`, `drive_turn_now`, `speed_pwm`, in spare padding bytes |
| Wi-Fi stalls: 1,810 rows where a drive step was running but the command had run out | the action column says 0 while the operator meant to drive: label noise | tooling done for scripted runs (`step` column says what was asked); the stall itself is an open item (CHANGELOG) |
| Logs from before the encoder detector (2026-10-25) have a dead left encoder with no flag 32 | wrong wheel data | done in tooling: `dataset.py` re-runs the firmware's fault rule and drops those rows (3,271) |
| Old `# gains_vN` lines have no `dff` | can't tell feedforward settings apart | done: `dataset.py` fills it from the header; `logger.py` and `handheld.py` now share one `GAIN_KEYS` list |
| `speed_l`/`speed_r` read 3.3x low before log format 10 (`constrain()` bug, CHANGELOG 2026-10-26) | wrong speeds, and the controller acted on them | done: firmware fixed (format 10); `dataset.py` rescales old logs by 10/3 |
| Units: 520 counts per turn is assumed, wheel size and track width unmeasured | speeds and turns in real units (m/s, deg/s) for a model that moves in the room | measure them (docs/API.md, AI-agent milestone item 2) |

## 7. Steps (one at a time, tested on the bot between each)

| # | Step | You test | Motors? |
|---|---|---|---|
| 1 | `bb1` skeleton: config, IMU, bias calibration, complementary filter, print pitch over serial | tilt it, pitch follows and doesn't drift | no |
| 2 | Two cores: control loop on core 1 at 200 Hz, loop-time stats, log record + ring buffer | loop time steady | no |
| 3 | Wi-Fi (own network + home network setting) + page with live pitch chart | open the page on phone/Mac | no |
| 4 | Log Record / Download on the page, live log view, `logger.py` (plotting: `check_dump.py --plot`), offline mock | log a tilt run, plot it | no |
| 5 | Motors + encoders in `bb1`, timed motor test from the page | wheels in the air | yes, timed |
| 6 | Arm/disarm, safety checks, angle PD loop | hand-held, then on the floor | yes |
| 7 | Live gain tuning, step test, save gains | tune per PID_TUNING.md | yes |
| 8 | Speed loop on the encoders, stop drift | stands still in place | yes |
| 9 | (milestone 2) Drive pad: forward/back, turn (`drive.h`, `POST /drive`, docs/API.md; built 2026-10-25) | drives around | yes |

| 10 | (milestone 4) Fast drive step 1: live `aff` (acceleration lean feedforward), `dacc` (speed ramp), `lmax` (lean limit while driving), defaults = old behavior (firmware 3.4, 2026-10-28) | drive tests: time to speed, lean, PWM headroom, after-stop creep | yes |
| 10b | Trim learn `tl`: a position I term that is never reset, so a trim error stops coming back as a backward creep after each stop (firmware 3.5, 2026-10-29) | stand after drives: creep speed, `trim_learned` settling | yes |
| 11 | (milestone 4) Fast drive step 2: `DRIVE_MAX_SPEED` 1.0 -> 3.0, log format 12, lift detector against the target, speed guards, minimum stop deceleration (firmware 3.6, 2026-10-29, flashed; wood 1.0 and 1.5 pass, 2.0-3.0 need a longer floor) | the floor test plan below | yes |
| 12 | (milestone 4) Fast spins: `DRIVE_MAX_TURN` 1.0 -> 5.0, steering ±100 PWM, turn ramp 6, deadband per wheel (the turn jitter), gyro yaw-to-pitch correction, log format 13 (firmware 3.7, 2026-10-31, flashed) | `drive_test.py spin-100`, `-200`, `-300`, `-450`, then long spins both ways from the page | yes |

**Fast drive step 2 (built 2026-10-29, firmware 3.6, flashed the same day).** The plan from step 1, and what we did:

1. Log fields: the four `drive_` fields stay int8 but count 1/40 turns/s (`DRIVE_LOG_STEPS`, max 3.17, steps 0.025) instead of hundredths. int16 would have cost 8 KB of RAM at 83% static; 0.025 is finer than anything we command. `LOG_FORMAT` 12; the CSV still says turns/s, so `runs_db.py` and `dataset.py` read both formats the same (test added). The `static_assert` in `control.h` now checks against `DRIVE_LOG_STEPS`.
2. Lift detector: each wheel against its own drive target (speed plus or minus half the turn), over `LIFT_TURNS_PER_SEC` (4) for 0.5 s. Standing still = the old check.
3. Headroom: measured from the step 1 logs instead of the bench (PWM 102-106 of 200 at 1.0, no saturation, about 25 PWM per turn/s + deadband 10). Guarded in firmware: `dff x speed` stays under `cap - DRIVE_PWM_RESERVE` (80), and 0.2 s at the cap while driving backs the speed off (`drive.h` `speedCeiling()`). Flag 8 now also counts the PID + feedforward + deadband at the cap.
4. Stops: slowing down is never slower than `DRIVE_STOP_ACCEL_MIN` (3 turns/s per s): 1 s and about 0.27 m from 3 turns/s, whatever `dacc` is.
5. Limits: `/api` 6, AGENT.md (agent caps unchanged: 0.3), API.md, the mock, `bb1.py` (its `MAX_TRAVEL` stays a 3-turn distance), the page's Max speed slider (turns/s, default 1.0, up to 3.0), new `drive_test.py` tests.

**Floor test plan (wood, full pack, BB1 balancing at the defaults, a clear straight line of about 1.5 m ahead of the start and 0.5 m behind, someone ready to catch it):** `drive_test.py fwd-back-100`, then `-150`, `-200`, `-250`, `-300`, each only after the one before looked clean, two or three runs each. Per step read: **pwm** peak against the cap (200; under about 160 leaves room to balance), **sat%** (0 is the goal; any saturation means that speed is the limit for this cap), lean peaks against `lmax` (8), **stop** (expect about speed²/6 turns: 1.5 at 3.0), got speed against asked, `drive_speed_now` below `drive_speed` in the log (a guard held it back), and no "picked up" disarm (the lift detector must never trip on the floor). If a speed saturates, stay below it and decide on `cap`, `dff` or `lmax` before going on.

**Fast spins (firmware 3.7, 2026-10-31).** One spin on the spot = 4.49 turns of left-minus-right difference, so turn 5.0 is about 0.9 s per 360 (each wheel 2.5 turns/s, about 75 PWM of steering, yaw 400 deg/s, under the gyro's 500 deg/s range). Results (wood): every spin step held its turn rate within 0.9 wheel turns of the start, PWM peak 97 of 200. What we learned: the deadband belongs on each wheel (on the shared output it made turns judder), and the gyro needs a yaw-to-pitch correction (0.043) because the chip isn't perfectly level; the accelerometer needs none. Next: exact-angle spins (the firmware counts the heading and starts the stop ramp in time), and an "acceleration" drive mode (the stick sets the lean while held).

Each step is its own commit. Before any step that can move the motors I'll ask first, and you confirm the wheels are off the table.

## 8. Choices made (2026-10-21)

1. **Wi-Fi:** both. Own network by default; a saved setting joins a home network and turns the own network off; falls back to the own network if the home one isn't found.
2. **Build order:** web page and logging first (steps 3 and 4), then the PID.
3. **Logs:** saved through the browser (Download button) or on the Mac with `tools/logger.py`, same CSV format.
4. **Python tools** live in `tools/` with their own virtual environment `tools/venv`.
