hectorsvill/bb1-balance-bot-1/docs/SESSION_LOG.md

# Session log

Durable session notes live in the second brain (hectorsvill_brain), not in this file.

Append new sessions to `Projects/bb1 - balance bot 1/BB1 - Dev Log.md` (newest first).

This filename stays so links from the README and other docs keep working. Firmware changes are still listed in [CHANGELOG.md](CHANGELOG.md). The 2026-10-25 low-battery cut-out (flashed 2026-10-25) is recorded there and in [POWER_ON.md](POWER_ON.md) case 15.
