hectorsvill/bb1-balance-bot-1/docs/PID_LEARNING_PROMPT.md

# Prompt for a PID learning chat

This learning prompt moved to the second brain (hectorsvill_brain) as a learning asset.

Path: `Projects/bb1 - balance bot 1/` (learning asset).

This filename stays so links keep working. The in-repo tuning procedure is [PID_TUNING.md](PID_TUNING.md).
