hectorsvill/bb1-balance-bot-1/docs/PID_LESSON.md

# PID for a balancing robot

This lesson moved to the second brain Learning Log (hectorsvill_brain).

Path: `Projects/bb1 - balance bot 1/` Learning Log.

This filename stays so links keep working. The in-repo tuning procedure is [PID_TUNING.md](PID_TUNING.md).
