hectorsvill/bb1-balance-bot-1/tools/README.md

# tools/

Python helpers that run on the Mac, with their own virtual environment in `tools/venv/` (not in git, rebuilt from `requirements.txt`).

**How to set up and run everything (venv, folders, examples, common errors): [docs/TOOLS.md](../docs/TOOLS.md).**

| Script | What it does |
|---|---|
| `flash.py` | Plan a flash as JSON. `--execute` compiles `firmware/bb1`, checks BB1 is lying down, uploads, and shows the auto-arm state |
| `serial_log.py` | Reads the Pico's USB serial for N seconds, prints it, optionally saves it (`-o logs/run.txt`) |
| `summarize_serial.py` | Summarizes a captured `csv`-mode run, one line per second; `--plot` draws it |
| `check_dump.py` | Loads any log (serial `dump`, page Download, `logger.py`), checks nothing is missing, `--plot` draws it; `load_dump()` for your own scripts |
| `handheld.py` | (testing only) Arm test in one window: keys a = arm 5 s, Enter = disarm, q = save the log and quit; records over Wi-Fi like `logger.py` |
| `logger.py` | Records every log record from BB1 over Wi-Fi into `logs/bb1_<date>_<time>_<note>.csv` (same layout as the page's Download) |
| `drive_test.py` | **Moves BB1.** Runs a named drive test over Wi-Fi (stand, fwd-back-30/50, turn, arc), records it like `logger.py`, reports stop distance, heading, lean, saturation per step |
| `drive_explore.py` | **Moves BB1.** Random driving inside a box for up to an hour (odometry keeps it in), a log file every 5 min, for training data |
| `dataset.py` | Builds one clean training table from every real log (`logs/dataset/bb1_dataset.csv.gz`) and prints what's in it |
| `runs_db.py` | Keeps all our data in `logs/runs.sqlite` (runs, every tick, disarms, drive steps, gains, flashes, bb1.py commands); the recorders add each log as they save it, `build` catches up |
| `logs.py` | Read-only viewer: list, show, slice, download logs and run SQL, JSON out for AI agents; `serve` = a web page at http://localhost:8090 |
| `todo.py` | The todo list from the vault Roadmap (by milestone, progress bars), tick or add todos, status of firmware/runs/PRs/CI; JSON out for AI agents; `serve` = a web page at http://localhost:8091 |
| `mock_bb1.py` | A pretend BB1 on the Mac: serves the real page with made-up data at http://localhost:8080 |
| `bb1.py` | Control BB1 from the command line (state, arm, drive, stop, disarm, log), one JSON line out, safety checks built in; for scripts and AI agents (`docs/AGENT.md`). Records BB1's telemetry by itself while it drives |
| `session_log.py` | The background recorder `bb1.py` starts: every 5 ms record into `logs/` and `logs/runs.sqlite`, saved when the session ends (not run by hand) |
| `bb1_mcp.py` | **Can move BB1.** MCP server: the same `bb1.py` commands and `logs.py` lookups as tools for an agent app (`claude mcp add bb1 -- ...`, see docs/TOOLS.md). Python 3.10+ |
| `tests/test_tools.py` | The tools' tests (CI runs them): `tools/venv/bin/python -m unittest discover -s tools/tests -v`. Uses made-up logs (`tests/make_fixtures.py`) and the mock, never the robot or a real log |
| `cli_util.py` | Shared `--json` flag and exit codes (0 ok, 1 check failed, 2 usage/config, 130 Ctrl-C). Not run by hand |

`--json` and the exit codes for every script: [docs/TOOLS.md](../docs/TOOLS.md) (`--json` and exit codes). `flash.py` prints a plan unless you pass `--execute`. `drive_test.py --host` defaults to `$BB1_HOST` or `bb1.local`. Lint with `ruff check tools` (`ruff.toml`, `tools/requirements-dev.txt`).

Quick start, from the repo folder:

```bash
source tools/venv/bin/activate
```

```bash
python tools/summarize_serial.py logs/2026-10-21_step1_tilt2.txt --plot
```

Installed versions (2026-10-21, Python 3.9.6): pyserial 3.5, numpy 2.0.2, pandas 2.3.3, matplotlib 3.9.4.
