hectorsvill/bb1-balance-bot-1/cad/stl/hcsr04_holder.stl

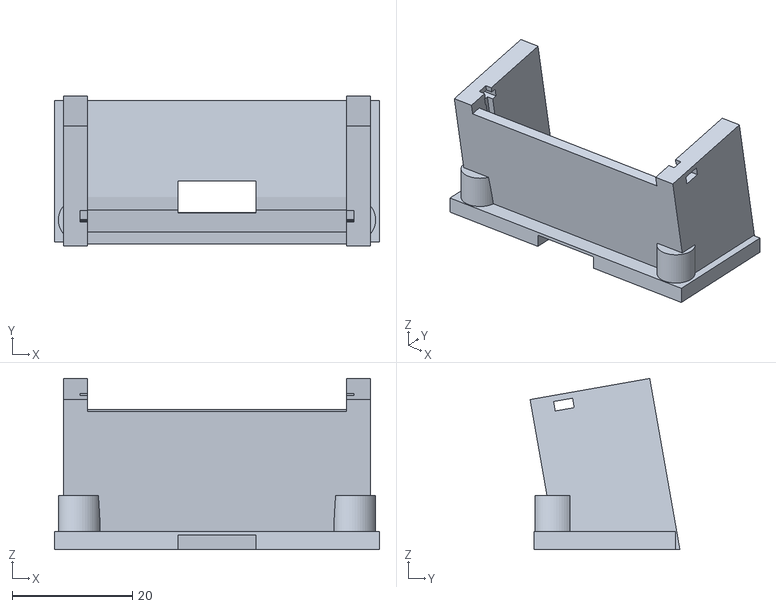
[picture p1: CAD file, 2026-10-21]
cad/stl/hcsr04_holder.stl
54.0 x 24.9 x 28.4
