hectorsvill/bb1-balance-bot-1/cad/stl/carrier_pico_sideways_m2.stl

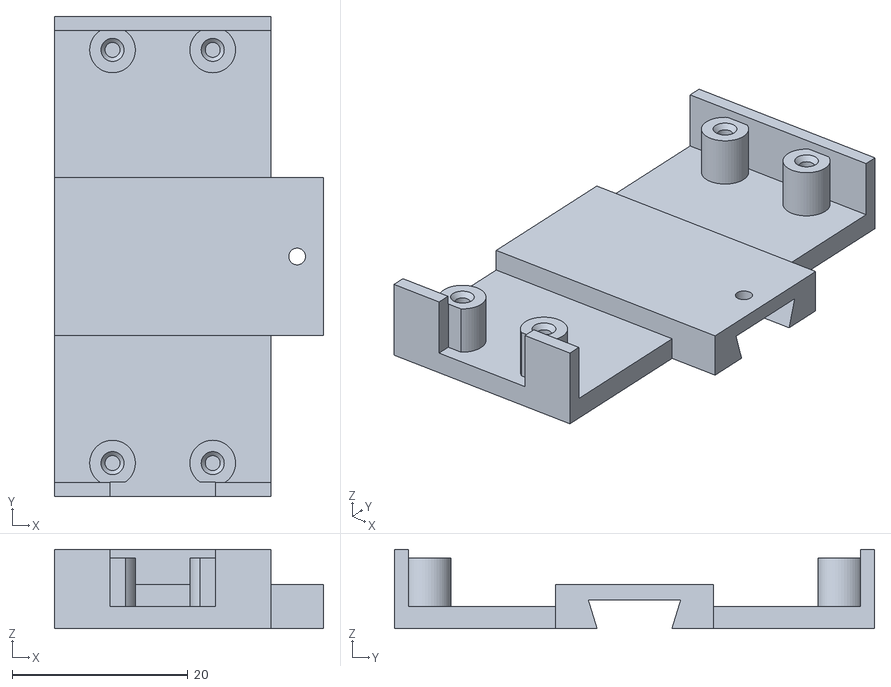
[picture p2: CAD file, 2026-10-21]
cad/stl/carrier_pico_sideways_m2.stl
30.6 x 54.6 x 9.00
