hectorsvill/bb1-balance-bot-1/cad/stl/carrier_d153c_m25.stl

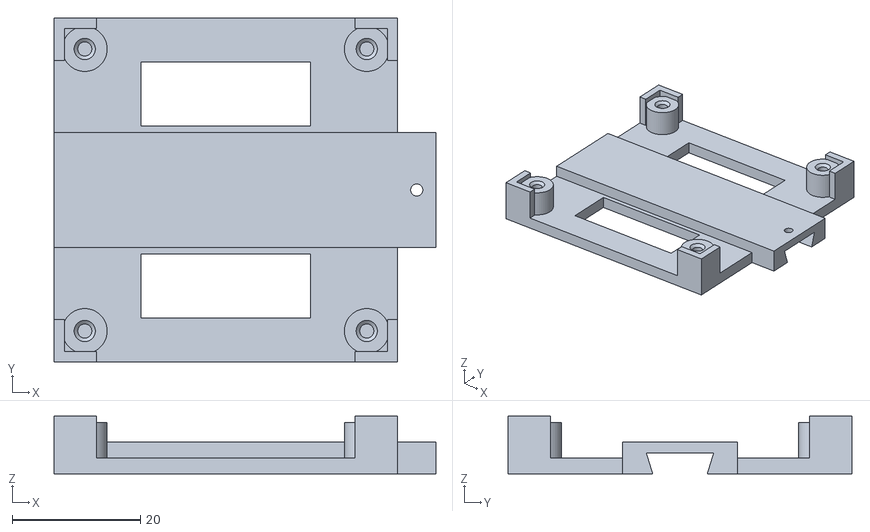
[picture p3: CAD file, 2026-10-21]
cad/stl/carrier_d153c_m25.stl
59.6 x 53.6 x 9.00
