hectorsvill/bb1-balance-bot-1/cad/stl/reverse_t_frame_short.stl

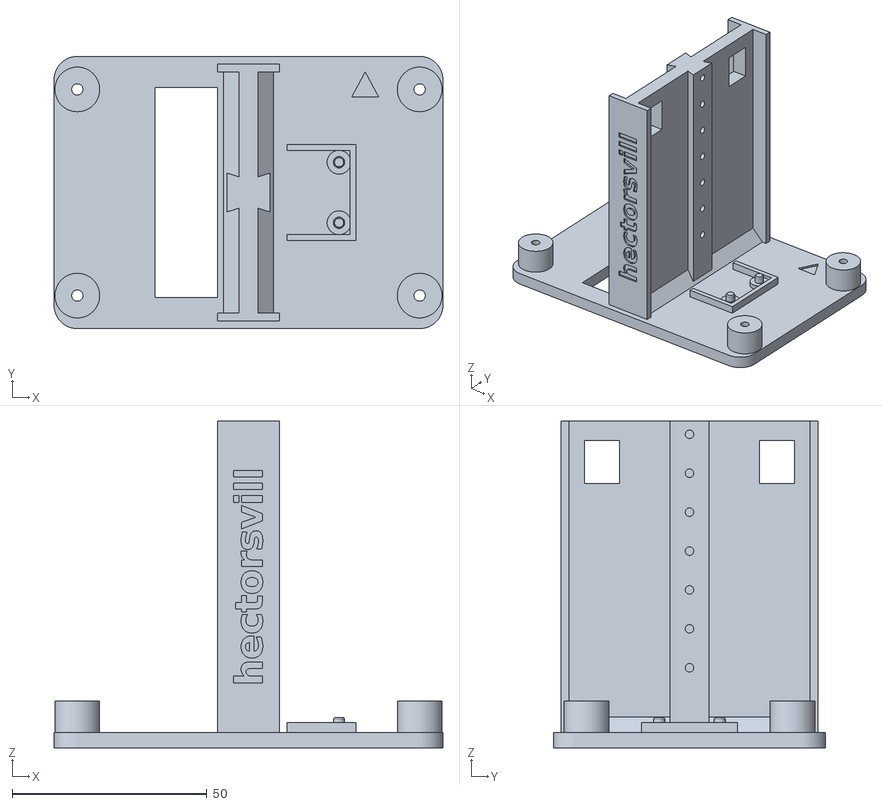
[picture p4: CAD file, 2026-10-21]
cad/stl/reverse_t_frame_short.stl
100.0 x 70.0 x 84.0
