hectorsvill/bb1-balance-bot-1/cad/stl/chassis_bottom_plate.stl

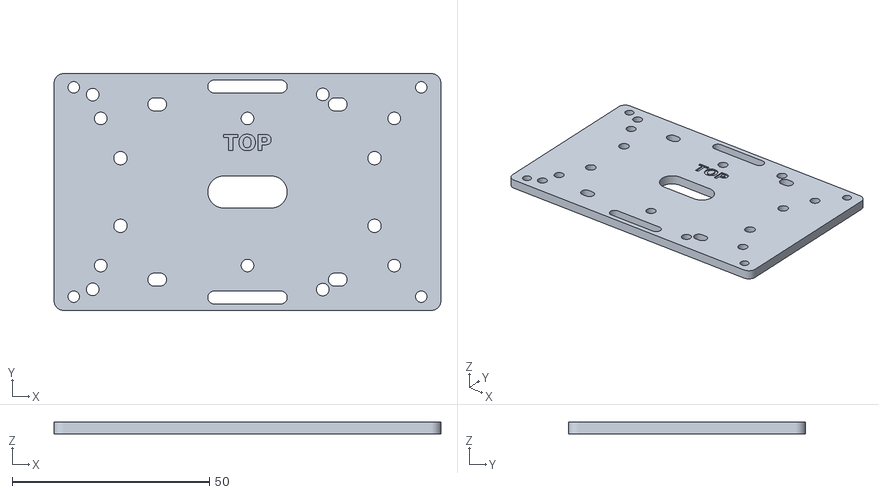
[picture p5: CAD file, 2026-10-21]
cad/stl/chassis_bottom_plate.stl
98.0 x 60.0 x 3.00
