hectorsvill/bb1-balance-bot-1/docs/WIRING.md

# Wiring

Pico physical pin numbers in brackets. D153C pin names follow its silkscreen.

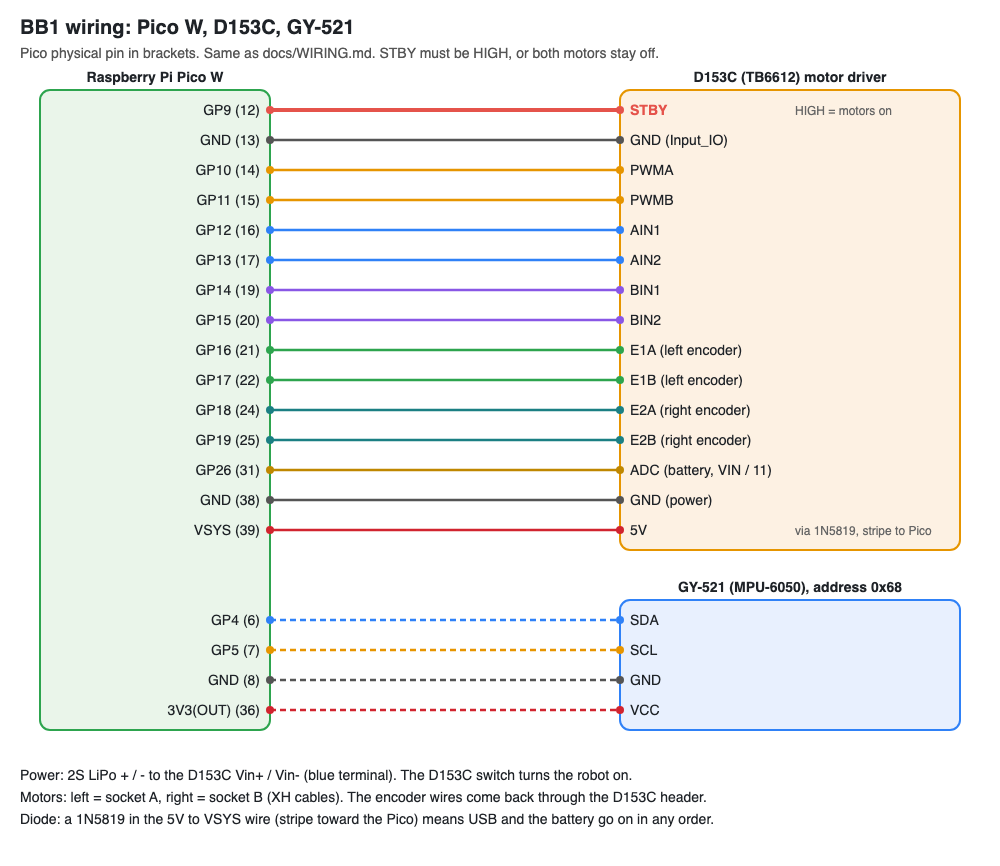
[picture p6: docs/wiring.png]
BB1 wiring diagram


The picture is drawn from the tables below by `tools/make_wiring_svg.py` (`wiring.svg`, and `wiring.png` for phones). Change a wire: update the table here and the list in that script, run it, then re-save the PNG (open `wiring.svg` in Chrome and screenshot, or see `docs/TOOLS.md`).

## Power

| From | To | Notes |
|---|---|---|
| 2S LiPo + / - | D153C Vin+ / Vin- (blue terminal) | D153C switch turns the robot on |
| D153C 5V | Pico VSYS (39) | Through a 1N5819 diode, stripe toward the Pico (2026-10-28) |
| D153C GND | Pico GND (38) | Common ground |

**Power order:** none needed since the diode went in. Since 2026-10-28 a 1N5819 Schottky diode sits in the D153C 5V to VSYS wire, stripe (cathode) toward the Pico. USB can no longer push 5 V backwards into the D153C's regulator, so USB and the battery can go on and off in any order. USB alone powers only the Pico and the IMU: the motors can't run without the battery.

## D153C to Pico

| D153C | Pico |
|---|---|
| STBY | GP9 (12), HIGH = on |
| GND (Input_IO) | GND (13) |
| PWMA | GP10 (14) |
| PWMB | GP11 (15) |
| AIN1 / AIN2 | GP12 (16) / GP13 (17) |
| BIN1 / BIN2 | GP14 (19) / GP15 (20) |
| E1A / E1B | GP16 (21) / GP17 (22) |
| E2A / E2B | GP18 (24) / GP19 (25) |

Motors plug into the D153C sockets with their XH cables: left = A, right = B.

## MPU-6050 (GY-521) to Pico

| GY-521 | Pico |
|---|---|
| VCC | 3V3(OUT) (36) |
| GND | GND (8) |
| SCL | GP5 (7) |
| SDA | GP4 (6) |
| XDA, XCL, AD0, INT | not connected (address 0x68) |

## Planned

| Part | Connection |
|---|---|
| HC-SR04 | VCC to D153C 5V, GND to GND, Trig to GP20 (26), Echo through 1k to GP21 (27) with 2k from GP21 to GND (HC-SR04P: 3V3 and no resistors) |
| Battery sense | D153C Output_IO header `ADC` pin (H2 pin 5, already VIN / 11 on the board) to GP26 (31). No resistors needed (KIT_REFERENCE.md) |
| OLED | I2C1 on GP6 (9) / GP7 (10) |
| Pi Zero W | Pico GP0 TX (1) to Pi pin 10, Pico GP1 RX (2) from Pi pin 8, 5V and GND from the D153C |
