hectorsvill/bb1-balance-bot-1/docs/BUILD_RECORD.md

# Build record

The as-built story and test write-ups live in the second brain (hectorsvill_brain), not in this file.

Path: `Projects/bb1 - balance bot 1/BB1 - Build Record.md` (or `Projects/bb1 - balance bot 1/Logs/`).

This filename stays so links keep working. Pins, signs, and wiring the firmware still needs are in [WIRING.md](WIRING.md) and CLAUDE.md.
