hectorsvill/bb1-balance-bot-1/docs/TUNING_LOG.md

# Tuning log

Durable tuning rounds live in the second brain (hectorsvill_brain), not in this file.

Path: `Projects/bb1 - balance bot 1/Logs/` or `Projects/bb1 - balance bot 1/BB1 - Tuning Log.md`.

This filename stays so links keep working. Read a captured log with `tools/pid_report.py`. The in-repo procedure is [PID_TUNING.md](PID_TUNING.md).
