hectorsvill/bb1-balance-bot-1/firmware/bb1/telemetry.h

// telemetry.h - the log record and the ring buffer that holds the last few seconds.
//
// Every control tick (200 per second), core 1 fills one LogRecord and pushes it
// into a ring buffer: a fixed array where the newest record overwrites the oldest.
// Core 0 reads records out of it to print them, and later to send them to the
// web page or tools/logger.py.
//
// Why a record per tick: these logs are meant to train a model later, so we keep
// everything the robot sensed (raw, unfiltered), what it estimated, and (from
// step 5 on) what it was told to do and what it did. Add new fields at the END
// of LogData (below) and to CSV_HEADER / formatCsv(), and document them in
// docs/CALIBRATION_AND_LOGS.md.

#pragma once
#include <pico/mutex.h>
#include "config.h"

// What the robot is doing. Stored in every record.
enum Mode : uint8_t {
  MODE_BOOT        = 0,
  MODE_CALIBRATING = 1,
  MODE_RUNNING     = 2,   // reading sensors, motors off (until step 6 adds DISARMED / ARMED)
  MODE_MOTOR_TEST  = 3,   // a timed motor test is running (step 5)
  MODE_ARMED       = 4,   // balancing: the PID drives the motors (step 6)
  MODE_FALLEN      = 5,   // fell over while armed; motors off until you arm or disarm again
};

// Bits in LogRecord::flags
const uint8_t FLAG_IMU_ERROR = 1 << 0;   // the IMU read failed this tick (sensor fields repeat the last good values)
const uint8_t FLAG_OVERRUN   = 1 << 1;   // the previous tick's work took longer than 5 ms
const uint8_t FLAG_NO_BIAS   = 1 << 2;   // no successful gyro calibration yet: using GYRO_BIAS_TYPICAL (config.h)
const uint8_t FLAG_SATURATED = 1 << 3;   // armed and the motor PWM hit the cap (since log format 12 also PID + drive feedforward + deadband; before, the PID alone)
const uint8_t FLAG_DRIVE_STOPPING = 1 << 4;   // a drive command ran out or was stopped: ramping to a stop (drive.h)
const uint8_t FLAG_ENC_FAULT = 1 << 5;   // an encoder isn't counting (control.h): heading hold off, driving refused
const uint8_t FLAG_I_RELAX   = 1 << 6;   // the angle I term is being drained after a drive (irelax, control.h)

// What the ring buffer stores for one control tick: 72 bytes (since firmware 3.3);
// 2000 of them (10 s) use 144,000 bytes of the 264 KB RAM, more than half of it.
// (Step 5 added 16 bytes: encoders, wheel speeds, motor commands. Step 6 added
// 12: the controller. Its terms are stored x10 as whole numbers, 2 bytes each
// instead of 4 for a float, to keep the 10 s buffer within RAM.)
// The tick number is NOT stored here: see LogRecord below.
struct LogData {
  uint32_t t_us;          // micros() when the tick started
  uint16_t work_us;       // how long this tick's work took
  uint8_t  mode;          // Mode
  uint8_t  flags;         // FLAG_* bits
  int16_t  raw[7];        // IMU exactly as read: ax, ay, az, temp, gx, gy, gz (gyro NOT bias-corrected)
  // 2026-11-03 (log format 14, firmware 3.10): exact-angle spins. Placed here, not at the
  // end, on purpose: raw[] ends 2 bytes before the next float, and the compiler
  // left those 2 bytes empty (padding). This field fills them, so the record
  // stays 72 bytes; at the end it would have cost 8 KB of RAM (static_assert below).
  int16_t  spin_left_x10; // deg still to turn in an exact-angle spin, x10, right + (0 = no spin; drive.h)
  float    pitch;         // deg, filtered, forward +
  float    pitch_rate;    // deg/s, bias-corrected, forward +
  float    accel_pitch;   // deg, accelerometer only
  // step 5: wheels. Forward is positive for all of these.
  int32_t  enc_l;         // left encoder counts since boot
  int32_t  enc_r;         // right encoder counts since boot
  int16_t  speed_l;       // left wheel speed, counts/s (over the last 50 ms)
  int16_t  speed_r;       // right wheel speed, counts/s
  int16_t  pwm_l;         // PWM sent to the left motor this tick, -255..255 (the "action")
  int16_t  pwm_r;         // PWM sent to the right motor
  // step 6: the balance controller (0 when disarmed)
  int16_t  setpoint_cdeg; // balance trim, hundredths of a degree
  int16_t  p_x10;         // P term in PWM, x10 (so 123 = 12.3 PWM)
  int16_t  i_x10;         // I term
  int16_t  d_x10;         // D term
  uint16_t gains_ver;     // which gains were in use (counts up on every change)
  uint8_t  reason;        // why it last disarmed or refused to arm (Reason in control.h; 0 = none).
                          // Fits in what used to be padding, so the record stays 68 bytes.
  uint8_t  web_age;       // time since the page last asked for /state, in 10 ms steps (255 = 2.55 s or more).
                          // Shows Wi-Fi stalls; the last padding byte.
  // 2026-10-24: battery (log format 6). Makes the record 72 bytes (2 bytes of padding left).
  uint16_t batt_mv;       // battery voltage in mV (battery.h; 0 = no wire / switch off)
  // 2026-10-24: auto-arm (log format 7). Uses 1 of the 2 padding bytes: still 72 bytes.
  uint8_t  auto_state;    // AutoState in auto_arm.h: why it is or isn't starting by itself
  // 2026-10-25: driving (log format 9). Makes the record 76 bytes (+8 KB for the 10 s buffer).
  // The four drive_ fields are in 1/DRIVE_LOG_STEPS turns/s (below) since log format 12.
  int8_t   drive_speed;   // operator command in force: speed, wheel turns/s, forward + (drive.h; 0 once it runs out)
  int8_t   drive_turn;    // operator command: turn, turns/s, right + (the "action" a model would learn to copy)
  // 2026-10-26 (log format 11): the controller's own state, in the last 3 padding bytes (still 76 bytes)
  int8_t   drive_speed_now; // ramped speed target BB1 really aims for
  int8_t   drive_turn_now;  // ramped turn target
  int8_t   speed_pwm;       // PWM the wheel speed loop added this tick (smode 1; 0 in smode 0)
};

static_assert(sizeof(LogData) == 72, "LogData grew: 2000 records x the extra bytes of RAM. Look for padding first (see spin_left_x10)");

// The drive_ fields' unit (log format 12, firmware 3.6). They were hundredths of
// a turn/s, and an int8 holds -128..127, so 1.27 turns/s was the most they
// could say. Fast drive allows 3.0. Two ways to fit it:
//   int16 hundredths: 4 more bytes per record (2 fields x 2 bytes, padded)
//                     = 8 KB of RAM for the 10 s buffer, at 83% static RAM.
//   int8 in 1/40ths:  max 127 / 40 = 3.17 turns/s, steps of 0.025 turns/s
//                     (4.4 mm/s of wheel travel), no RAM at all.
// 0.025 is finer than anything we command (the page and the tools send 0.05
// steps, which are exact in 1/40ths), so int8 1/40ths it is. The CSV still
// says turns/s, so tools reading the CSV need no change.
constexpr float DRIVE_LOG_STEPS = 40;

// Turn goes to 5.0 for spins (firmware 3.7, log format 13), past 3.17, so
// drive_turn and drive_turn_now are stored in 1/20ths: max 6.35, steps of
// 0.05 turns/s (still exact for the 0.05 steps the page and tools send).
constexpr float DRIVE_TURN_LOG_STEPS = 20;

// turns/s -> the int8 the log stores (control.h).
int8_t driveLogValue(float turnsPerSec) {
  return (int8_t)constrain(lroundf(turnsPerSec * DRIVE_LOG_STEPS), -127L, 127L);
}
int8_t driveTurnLogValue(float turnsPerSec) {
  return (int8_t)constrain(lroundf(turnsPerSec * DRIVE_TURN_LOG_STEPS), -127L, 127L);
}

// One full record, as the rest of the firmware sees it: the stored fields plus
// the tick number. tick counts up by 1 every tick since boot (a gap in a log
// file means lost records); it's the first CSV column and what GET /log?since=
// asks for.
//
// Why tick isn't kept in the buffer: loop1() pushes exactly one record per
// tick, starting at tick 0 (a calibration pause skips the tick counter too), so
// record number n in the buffer IS tick n. logGet(n) writes n back into .tick.
// Storing it again would cost 4 bytes x 2000 records = 8 KB of RAM for a
// number we already know (firmware 3.3; the CSV is exactly the same).
struct LogRecord : LogData {
  uint32_t tick;
};

// ---------- the ring buffer ----------
//
//   slot:    0    1    2    3   ...  1999
//          [ r2000 r2001 r1998 r1999 ... ]   <- after 2001 records, the oldest are overwritten
//
// totalWritten counts every record ever pushed. The newest record is in slot
// (totalWritten - 1) % size, and record number n (its tick) lives in slot n % size.
//
// The mutex: core 1 writes a slot while core 0 might be copying the same slot.
// Without a lock, core 0 could copy half an old record and half a new one.
// Each side holds the lock only while copying one 72-byte record (about a
// microsecond), so core 1 never waits long.

LogData logBuffer[LOG_BUFFER_RECORDS];
volatile uint32_t totalWritten = 0;
auto_init_mutex(logMutex);

// Core 1: add the newest record. It becomes record number totalWritten, which
// is the same as r.tick (see LogRecord), so only the LogData part is copied.
void logPush(const LogRecord &r) {
  mutex_enter_blocking(&logMutex);
  logBuffer[totalWritten % LOG_BUFFER_RECORDS] = r;   // copies the LogData part
  totalWritten = totalWritten + 1;
  mutex_exit(&logMutex);
}

// Core 0: copy record number n out. Returns false if it's already been
// overwritten (too old) or doesn't exist yet.
bool logGet(uint32_t n, LogRecord &out) {
  bool ok = false;
  mutex_enter_blocking(&logMutex);
  uint32_t total = totalWritten;
  if (n < total && total - n <= LOG_BUFFER_RECORDS) {
    static_cast<LogData &>(out) = logBuffer[n % LOG_BUFFER_RECORDS];   // the stored fields
    out.tick = n;                                                     // record n = tick n
    ok = true;
  }
  mutex_exit(&logMutex);
  return ok;
}

// The number of the oldest record still in the buffer.
uint32_t logOldest() {
  uint32_t total = totalWritten;
  return total > LOG_BUFFER_RECORDS ? total - LOG_BUFFER_RECORDS : 0;
}

// ---------- CSV ----------
// One header line and one line per record. The same columns will be used by
// the web page download and tools/logger.py.

const char *CSV_HEADER =
  "tick,t_us,work_us,mode,flag_bits,ax_raw,ay_raw,az_raw,temp_raw,gx_raw,gy_raw,gz_raw,pitch,pitch_rate,accel_pitch,"
  "enc_l,enc_r,speed_l,speed_r,pwm_l,pwm_r,setpoint,p_term,i_term,d_term,gains_ver,reason,web_age_ms,batt_v,auto_state,drive_speed,drive_turn,drive_speed_now,drive_turn_now,speed_pwm,spin_left";

void csvHeader(Print &p) {
  p.println(CSV_HEADER);
}

// Longest CSV line, with every field at its widest: about 260 bytes since log
// format 14 (typical lines are about 170). Was 240 before spin_left.
const int CSV_LINE_MAX = 320;

// Write one record as a CSV line (with "\n") into buf. Returns the length.
int formatCsv(char *buf, size_t size, const LogRecord &r) {
  return snprintf(buf, size, "%lu,%lu,%u,%u,%u,%d,%d,%d,%d,%d,%d,%d,%.3f,%.3f,%.3f,%ld,%ld,%d,%d,%d,%d,%.2f,%.1f,%.1f,%.1f,%u,%u,%u,%.2f,%u,%.3f,%.3f,%.3f,%.3f,%d,%.1f\n",
                  (unsigned long)r.tick, (unsigned long)r.t_us, r.work_us, r.mode, r.flags,
                  r.raw[0], r.raw[1], r.raw[2], r.raw[3], r.raw[4], r.raw[5], r.raw[6],
                  r.pitch, r.pitch_rate, r.accel_pitch,
                  (long)r.enc_l, (long)r.enc_r, r.speed_l, r.speed_r, r.pwm_l, r.pwm_r,
                  r.setpoint_cdeg / 100.0, r.p_x10 / 10.0, r.i_x10 / 10.0, r.d_x10 / 10.0, r.gains_ver, r.reason, r.web_age * 10, r.batt_mv / 1000.0, r.auto_state, r.drive_speed / DRIVE_LOG_STEPS, r.drive_turn / DRIVE_TURN_LOG_STEPS,
                  r.drive_speed_now / DRIVE_LOG_STEPS, r.drive_turn_now / DRIVE_TURN_LOG_STEPS, r.speed_pwm, r.spin_left_x10 / 10.0);
}

void printCsv(Print &p, const LogRecord &r) {
  char buf[CSV_LINE_MAX];
  formatCsv(buf, sizeof(buf), r);
  p.print(buf);
}
