hectorsvill/bb1-balance-bot-1/firmware/bb1/log_meta.h

// log_meta.h - the "# setting,value" lines at the top of every log file.
//
// A log file should explain itself months later (and to a model trained on it):
// which firmware made it, the gyro bias that was subtracted, the filter weight,
// and how to turn raw counts into units. Every way of saving a log uses this
// same block: the serial "dump", the web page's Download, and tools/logger.py.

#pragma once
#include "config.h"
#include "imu.h"
#include "shared.h"
#include "version.h"

// Bump this when the log columns change, so old and new files can be told apart.
const char *FIRMWARE_NAME = "bb1 milestone 2";
const int   LOG_FORMAT    = 14;  // 2: step 5 added enc_l..pwm_r; 3: step 6 added setpoint..gains_ver; 4: reason; 5: web_age_ms; 6: batt_v; 7: auto_state; 8: auto_state 3 now means "no IMU" (was "waiting for calibration"); 9: drive_speed, drive_turn, flag 16 = drive stopping; 10: speed_l/speed_r really over 10 ticks (before: 3 ticks, read 3.3x low); 11: drive_speed_now, drive_turn_now, speed_pwm; 12: the four drive_ columns stored in 1/40 turns/s (CSV still turns/s, now 3 decimals, up to 3.17), flag 8 also counts PID + drive feedforward hitting the cap; 13: drive_turn and drive_turn_now stored in 1/20 turns/s (CSV still turns/s, up to 6.35) for turn 5.0 spins, deadband added per wheel; 14: spin_left (exact-angle spins, deg still to turn)

String logMetaLines() {
  String m;
  m.reserve(1280);   // about 1100 bytes: one heap block up front instead of growing it line by line
  m += "# firmware," + String(FIRMWARE_NAME) + "\n";
  m += "# firmware_version," + String(FIRMWARE_VERSION) + ",build_id," + String(BB1_BUILD_ID) + "\n";   // version.h
  m += "# log_format," + String(LOG_FORMAT) + "\n";
  m += "# imu_start,tries," + String(imuTries) + ",bus_pulses," + String(imuBusPulses) + "\n";   // imu.h: how hard startup had to work to find the chip
  m += "# gyro_bias_dps," + String(gyroBias[0], 3) + "," + String(gyroBias[1], 3) + "," + String(gyroBias[2], 3) + "\n";
  m += "# alpha," + String(requestedAlpha, 3) + ",loop_hz," + String(LOOP_HZ) +
       ",accel_lsb_per_g," + String(ACCEL_PER_G, 1) + ",gyro_lsb_per_dps," + String(GYRO_PER_DPS, 1) + "\n";
  m += "# accel_pitch_sign," + String((int)ACCEL_PITCH_SIGN) + ",gyro_pitch_sign," + String((int)GYRO_PITCH_SIGN) + "\n";
  m += "# counts_per_rev," + String(COUNTS_PER_REV) + ",speed_window_ticks," + String(SPEED_WINDOW) +
       ",pwm_max," + String(PWM_MAX) + ",pwm_freq_hz," + String(PWM_FREQ) + "\n";
  m += "# battery_divider," + String(BATTERY_DIVIDER, 2) + ",battery_pin,GP" + String(BATTERY_PIN) + ",battery_cells," + String(BATTERY_CELLS) + "\n";
  m += "# gains_ver," + String(gainsVersion) + ",kp," + String(gainP, 3) + ",ki," + String(gainI, 3) +
       ",kd," + String(gainD, 3) + ",trim," + String(balanceTrim, 2) + ",pwm_cap," + String(pwmCap, 0) +
       ",deadband," + String(motorDeadband, 0) + ",speed_p," + String(gainSpeedP, 2) + ",speed_i," + String(gainSpeedI, 2) + ",turn_hold," + String(gainTurnHold, 1) + ",auto_arm," + String((int)autoArm) + ",drive_ff," + String(gainDriveFF, 0) + ",drive_speed_i," + String(gainDriveSpeedI, 2) + ",speed_mode," + String((int)speedMode) + ",wheel_speed_p," + String(gainWheelSpeedP, 1) + ",wheel_speed_i," + String(gainWheelSpeedI, 1) + ",i_relax," + String(gainIRelax, 2) +
       ",accel_ff," + String(gainAccelFF, 2) + ",drive_accel," + String(driveAccelRate, 2) + ",lean_max," + String(driveLeanMax, 1) + ",trim_learn," + String(gainTrimLearn, 2) + "\n";
  m += "# drive_max_speed," + String(DRIVE_MAX_SPEED, 2) + ",drive_max_turn," + String(DRIVE_MAX_TURN, 2) + ",drive_accel," + String(driveAccelRate, 2) +
       ",drive_turn_accel," + String(DRIVE_TURN_ACCEL, 2) + ",drive_turn_ff," + String(DRIVE_TURN_FF, 1) + ",drive_hold_ms," + String(DRIVE_HOLD_MS) +
       ",speed_shift_max," + String(SPEED_SHIFT_MAX, 1) + ",lean_limit_ease_dps," + String(LEAN_LIMIT_EASE_DPS, 1) +
       ",drive_pwm_reserve," + String(DRIVE_PWM_RESERVE, 0) + ",drive_sat_backoff_s," + String(DRIVE_SAT_BACKOFF_S, 2) +
       ",drive_stop_accel_min," + String(DRIVE_STOP_ACCEL_MIN, 2) + ",lift_tps," + String(LIFT_TURNS_PER_SEC, 1) + ",lift_ms," + String(LIFT_MS) + "\n";
  m += "# spin_max_deg," + String((int)SPIN_MAX_DEG) + ",spin_min_deg," + String((int)SPIN_MIN_DEG) + ",spin_min_rate," + String(SPIN_MIN_RATE, 2) +
       ",spin_default_rate," + String(SPIN_DEFAULT_RATE, 2) + ",gyro_yaw_sign," + String((int)GYRO_YAW_SIGN) +
       ",spin_settle_s," + String(SPIN_SETTLE_S, 2) + ",spin_settle_gain," + String(SPIN_SETTLE_GAIN, 3) + ",spin_settle_max_turn," + String(SPIN_SETTLE_MAX_TURN, 2) +
       ",spin_settle_deg," + String(SPIN_SETTLE_DEG, 1) + ",spin_settle_dps," + String(SPIN_SETTLE_DPS, 0) + "\n";
  return m;
}
