hectorsvill/bb1-balance-bot-1/tools/drive_test.py

"""drive_test.py - drive BB1 through a named test over Wi-Fi, record it, report it.

Usage (BB1 must already be balancing on the floor; --host defaults to $BB1_HOST or bb1.local):
    tools/venv/bin/python tools/drive_test.py stand            # 30 s standing still
    tools/venv/bin/python tools/drive_test.py fwd-back-30 -n "dff 60"
    tools/venv/bin/python tools/drive_test.py --list           # what each test does
    tools/venv/bin/python tools/drive_test.py --report logs/bb1_..._drive-test.csv   # re-read a saved run

Tests: stand, fwd-back-30, fwd-back-50, turn, arc, all (the five in a row),
and the fast ones (firmware 3.6, run them one at a time in this order):
fwd-back-100, fwd-back-150, fwd-back-200, fwd-back-250, fwd-back-300.
Spins (firmware 3.7, on the spot, same order): spin-100, spin-200, spin-300,
spin-450: one full spin right, then one left, at that turn rate.
Exact-angle spins (firmware 3.10, POST /spin, the firmware lands on the angle
by itself): exact-200, exact-400: 90 right, 90 left, 360 right, 360 left at
turn rate 2 or 4. The report adds the real angle from the gyro and the error.
Each fast step is 1.5 s long, ramp included, so it rolls at most speed x 1.5
wheel turns out and the same back: fwd-back-300 goes about 4.5 turns (0.8 m)
forward, then back. Give it a clear straight line of about 1.5 m ahead of
the start and 0.5 m behind (room for the stop and the after-stop roll).

Safety, in this order of importance:
  - refuses to start unless /state says armed and enc_fault 0
  - every /drive command lasts CMD_MS (3 s) and is re-sent every 100 ms,
    like the page; nothing longer than MAX_CMD_MS (3 s) is ever sent. If this
    script dies, BB1 stops by itself within 3 s (the firmware failsafe).
    Steps faster than 1 turn/s send FAST_CMD_MS (1 s) commands instead
  - POST /drive/stop between steps, and on any error, fall or Ctrl-C
  - checks /state twice a second: disarmed (fell, STOP), encoder fault, or more than
    MAX_TRAVEL (3) wheel turns from the start ends the test. A fast test plans
    more than that, so its limit is its longest step (speed x seconds) plus
    TRAVEL_MARGIN (travel_limit()): still a stop for a run that runs away

The log is the same file logger.py writes (logs/bb1_<date>_<time>_<note>.csv),
plus one "# step,name,speed,turn,start_tick,end_tick" line per step so the
report (and a model trained later) knows what was asked when.
"""

import argparse
import json
import os
import socket
import sys
import time
import urllib.error
from datetime import datetime

import numpy as np

import cli_util
from check_dump import find_file, load_dump
from logger import MAX_PER_REQUEST, fetch_log, gains_versions, get, log_path, post, save_log

_JSON = False


def say(*args, **kwargs):
    """Progress. With --json this goes to stderr so stdout stays one JSON document."""
    kwargs["file"] = sys.stderr if _JSON else sys.stdout
    print(*args, **kwargs)


COUNTS_PER_REV = 520           # config.h, assumed
GYRO_LSB = 65.5                # imu.h GYRO_PER_DPS: gyro counts per deg/s (+/-500 deg/s range)
CMD_MS = 3000                  # how long each /drive command lasts (re-sent every 100 ms). Was 1000: about
                               # every 10 s one GET /log answer takes 1-2.5 s, the Pico serves nothing else
                               # meanwhile, and a 1 s command ran out: 41% of the moving time in the first
                               # training run (2026-10-26). 3 s rides over that. Cost: if this script dies,
                               # BB1 drives on up to 3 s (0.21 m at 0.4 turns/s) before its failsafe stops it
MAX_CMD_MS = 3000              # hard limit: never ask for more than this (= the firmware's DRIVE_HOLD_MAX_MS)
RESEND_S = 0.1                 # re-send the command this often (the page does too)
FLAG_SAT, FLAG_STOPPING, FLAG_ENC_FAULT = 8, 16, 32   # telemetry.h
MAX_TRAVEL = 3.0               # wheel turns (about 0.53 m) from where the test started: stop the test.
                               # Without it, fwd-back runs crept back 1 turn each and BB1 hit a wall (2026-10-26)
TRAVEL_MARGIN = 1.5            # fast tests: turns allowed past the planned step (one 0.5 s /state check at 3 turns/s)
FAST_CMD_MS = 1000             # steps faster than 1 turn/s: if this script dies at 3 turns/s, a 3 s command
                               # would roll on 9 turns (1.6 m). 1 s + the 1 s stop is about 4.5 turns. A Wi-Fi
                               # stall may cut such a step short (BB1 ramps to a stop): the report's "drop" shows it
STALL_S = 2.0                  # give up after this long with no answer at all from BB1

# A step is (name, speed turns/s, turn turns/s, seconds). Speed and turn 0 =
# no command: BB1 just balances (a pause to see how it stops).
P = ("pause", 0.0, 0.0, 3.0)
TESTS = {
    "stand":       [("stand", 0.0, 0.0, 30.0)],
    "fwd-back-30": [P, ("fwd 0.3", 0.3, 0.0, 3.0), P, ("back 0.3", -0.3, 0.0, 3.0), P],
    "fwd-back-50": [P, ("fwd 0.5", 0.5, 0.0, 3.0), P, ("back 0.5", -0.5, 0.0, 3.0), P],
    "turn":        [P, ("left 0.5", 0.0, -0.5, 3.0), P, ("right 0.5", 0.0, 0.5, 3.0), P],
    "arc":         [P, ("fwd 0.3 right 0.3", 0.3, 0.3, 3.0), P, ("fwd 0.3 left 0.3", 0.3, -0.3, 3.0), P],
}
TESTS["all"] = sum((TESTS[k] for k in ("stand", "fwd-back-30", "fwd-back-50", "turn", "arc")), [])
# Fast drive step 2 (firmware 3.6). 1.5 s per step, ramp included: the target
# ramps at dacc (3 turns/s^2 by default), so at 3 turns/s it takes 1 s to reach
# speed and spends about 0.5 s there; at 1.5 turns/s, 1 s at speed. Up and down
# ramps are the same shape, so a step rolls about speed x 1.5 wheel turns.
for v in (1.0, 1.5, 2.0, 2.5, 3.0):
    TESTS[f"fwd-back-{v * 100:.0f}"] = [P, (f"fwd {v:g}", v, 0.0, 1.5), P, (f"back {v:g}", -v, 0.0, 1.5), P]
# Fast spins (firmware 3.7): one spin right, then one left, on the spot. A
# full spin is SPIN_TURNS of left-minus-right difference (pi x 127 mm track /
# 177.8 mm per wheel turn x 2). The turn ramps at 6 turns/s^2 both ways, so
# the ramp lost at the start comes back as roll-on after the command: a step
# of SPIN_TURNS / v seconds is about one spin. The report's "got trn" and
# "stop" say how close: x 80 = degrees.
SPIN_TURNS = 4.49
for v in (1.0, 2.0, 3.0, 4.5):
    TESTS[f"spin-{v * 100:.0f}"] = [P, (f"spin right {v:g}", 0.0, v, round(SPIN_TURNS / v, 2)), P,
                                    (f"spin left {v:g}", 0.0, -v, round(SPIN_TURNS / v, 2)), P]
# Exact-angle spins (firmware 3.10). One POST /spin per step; BB1 counts the
# angle with its gyro and lands on it by itself, so Wi-Fi timing doesn't
# matter. The step's name carries the angle ("exact 90", "exact -360", right
# +); its turn is the rate (sign = direction) and its seconds the most it
# waits: twice the planned time + 2 s (SPIN_DEG_PER_TURN, measured runs 189-190:
# the wheels scrub, so 360 deg is about 5.4 turns of difference, not 4.49).
EXACT = "exact "
SPIN_DEG_PER_TURN = 66.0
for v in (2.0, 4.0):
    TESTS[f"exact-{v * 100:.0f}"] = sum(([P, (f"{EXACT}{d:+.0f}", 0.0, v if d > 0 else -v,
                                              round(2 * abs(d) / (v * SPIN_DEG_PER_TURN) + 2, 1))]
                                         for d in (90, -90, 360, -360)), []) + [P]


def exact_deg(name):
    """The angle of an exact-spin step ("exact +90" -> 90.0), or None for any other step."""
    return float(name[len(EXACT):]) if name.startswith(EXACT) else None


def travel_limit(steps):
    """How far (wheel turns) a test may roll from the start before it is stopped:
    MAX_TRAVEL, or for a fast test its longest planned step plus TRAVEL_MARGIN."""
    return max(MAX_TRAVEL, max(abs(sp) * secs for _, sp, _, secs in steps) + TRAVEL_MARGIN)


class Stop(Exception):
    """The test has to end now (fell, STOP pressed, encoder fault, no answer)."""


class Run:
    """Talks to BB1: records the log, sends drive commands, watches /state."""

    def __init__(self, base):
        self.base = base
        self.rows, self.lost, self.header, self.versions = [], 0, "", {}
        self.next_tick = None
        self.last_fetch = self.last_check = 0.0
        self.last_answer = time.time()  # when BB1 last answered anything
        self.tick = 0                   # newest tick seen in /state
        self.home = None                # wheel position (turns) when the test started
        self.travel = 0.0               # turns from home, forward +
        self.max_travel = MAX_TRAVEL    # run_test() raises it for a fast test (travel_limit())
        self.spin_left = 0.0            # /state drive.spin_left: deg an exact spin still has to turn

    def ask(self, fn, *args, **kw):
        """Call BB1. Short Wi-Fi stalls (the Pico's server goes quiet for a second or
        two now and then) are ridden out: returns None and we try again next loop.
        BB1 is safe meanwhile, since each drive command runs out after CMD_MS.
        A refusal (HTTP 409 etc.) is a real answer and goes straight up."""
        try:
            out = fn(*args, **kw)
        except urllib.error.HTTPError:
            raise
        except OSError as e:          # timeout, connection reset
            if time.time() - self.last_answer > STALL_S:
                raise Stop(f"no answer from BB1 for {STALL_S:.0f} s ({e})")
            return None
        self.last_answer = time.time()
        return out

    def check(self, force=False):
        """Read /state (at most twice a second). Raises Stop if driving isn't safe."""
        if not force and time.time() - self.last_check < 0.5:
            return
        self.last_check = time.time()
        text = self.ask(get, f"{self.base}/state", timeout=1)
        if text is None:
            return
        s = json.loads(text)
        gains_versions(text, self.versions)          # remember gains changed mid-run (POST /gains)
        self.tick = s["tick"]
        self.spin_left = s.get("drive", {}).get("spin_left", 0.0) or 0.0
        if self.next_tick is None:
            self.next_tick = s["tick"] + 1            # record from now on
        if not s["armed"]:
            raise Stop(f"not balancing (reason: {s['reason'] or 'none'})")
        pos = (s["enc_l"] + s["enc_r"]) / 2 / COUNTS_PER_REV
        if self.home is None:
            self.home = pos
        self.travel = pos - self.home
        if abs(self.travel) > self.max_travel:
            raise Stop(f"{self.travel:+.1f} wheel turns from the start (limit {self.max_travel:g}): re-centre BB1")
        if s["enc_fault"]:
            raise Stop(f"encoder fault {s['enc_fault']} ({'left' if s['enc_fault'] == 1 else 'right'} encoder): check its wires")

    def record(self):
        """Pull new log records, about 4 times a second (like logger.py)."""
        if self.next_tick is None or time.time() - self.last_fetch < 0.25:
            return                     # (None: /state hasn't answered yet, so no start tick)
        self.last_fetch = time.time()
        while True:
            got = self.ask(fetch_log, self.base, self.next_tick)
            if got is None:
                return
            info, self.header, new = got
            self.rows += new
            self.lost += info["lost"]
            self.next_tick = info["to"]
            if info["to"] - info["from"] < MAX_PER_REQUEST:
                return

    def drive(self, speed, turn):
        ms = min(CMD_MS if abs(speed) <= 1.0 and abs(turn) <= 1.0 else FAST_CMD_MS, MAX_CMD_MS)
        try:
            self.ask(post, f"{self.base}/drive", timeout=0.5, speed=speed, turn=turn, ms=ms)
        except urllib.error.HTTPError as e:     # 409: not balancing, or encoder fault
            raise Stop(f"/drive refused: {e}")

    def stop(self):
        """Ask BB1 to stop driving. Tries 3 times; the CMD_MS failsafe covers the rest."""
        for _ in range(3):
            try:
                post(f"{self.base}/drive/stop", timeout=1)
                return
            except OSError:
                time.sleep(0.1)

    def spin(self, deg, rate, secs):
        """One exact-angle spin: one POST /spin, then wait until /state says it has
        landed (spin_left back to 0) or secs run out. BB1 does the rest itself."""
        try:
            self.ask(post, f"{self.base}/spin", timeout=1, deg=deg, rate=abs(rate))
        except urllib.error.HTTPError as e:     # 409: not balancing, or encoder fault
            raise Stop(f"/spin refused: {e}")
        start = time.time()
        while time.time() - start < secs:
            time.sleep(0.15)
            self.check(force=True)
            self.record()
            if time.time() - start > 0.5 and not self.spin_left:
                return                 # landed
        self.stop()                    # didn't land in time: stop it
        say(f"    no landing after {secs:g} s: stopped it")

    def step(self, name, speed, turn, secs):
        deg = exact_deg(name)
        if deg is not None:
            say(f"  {name:20s} up to {secs:4.1f} s  rate {abs(turn):.2f}")
            return self.spin(deg, turn, secs)
        moving = speed or turn
        say(f"  {name:20s} {secs:4.1f} s" + (f"  speed {speed:+.2f}  turn {turn:+.2f}" if moving else ""))
        end = time.time() + secs
        while time.time() < end:
            if moving:
                self.drive(speed, turn)
            self.check()
            self.record()
            time.sleep(RESEND_S)
        if moving:
            self.stop()                # stop between steps, don't wait for the failsafe


def run_test(base, test, note, surface, out):
    started = datetime.now()
    path = log_path(note or f"drive {test}", started, out)
    run = Run(base)
    run.max_travel = max(run.max_travel, travel_limit(TESTS[test]))   # max(): drive_explore turns the limit off
    meta = get(f"{base}/log/meta")
    try:
        run.check(force=True)          # refuse to start unless armed and no encoder fault
    except Stop as e:
        cli_util.fail(f"Not starting: {e}", cli_util.EXIT_FAIL, _JSON)
    steps, why = [], "done"
    say(f"Test '{test}', recording into {path.name}. Ctrl-C stops driving.")
    current = None                     # the step running now, kept even if it's cut short (a fall)
    try:
        for name, speed, turn, secs in TESTS[test]:
            run.check(force=True)
            current = (name, speed, turn, run.tick)
            run.step(name, speed, turn, secs)
            run.check(force=True)
            steps.append(current + (run.tick,))
            current = None
    except Stop as e:
        why = f"stopped: {e}"
    except KeyboardInterrupt:
        why = "stopped: Ctrl-C"
    except Exception as e:             # anything else: still stop driving and keep the log
        why = f"stopped: error {e!r}"
    finally:
        run.stop()
    say(f"  {why}. Ended {run.travel:+.1f} wheel turns from the start (forward +).")
    # Keep recording 2 s more so a fall or the stop is in the file. Falls are kept: they're data too.
    t_end = time.time() + 2
    while time.time() < t_end:
        try:
            run.last_fetch = 0
            run.record()
        except OSError:
            pass
        time.sleep(0.25)
    if current and run.rows:           # the cut-short step ends at the last record we got
        steps.append(current + (int(run.rows[-1].split(",", 1)[0]),))
    meta += "".join(f"# step,{n},{s:.2f},{t:.2f},{a},{b}\n" for n, s, t, a, b in steps)
    meta += f"# drive_test,{test},{why.replace(',', ';')}\n"
    save_log(path, meta, note or f"drive {test}", started, run.header, run.rows, run.lost, run.versions, surface,
             announce=not _JSON)
    return path


def _num(value, places=4):
    """JSON can't carry NaN. None means 'this step had nothing to measure there'."""
    try:
        number = float(value)
    except (TypeError, ValueError):
        return None
    if np.isnan(number):
        return None
    return round(number, places)


def report(path, as_json=False):
    """One line per step: what was asked, what the wheels did, how it stopped."""
    df, _ = load_dump(path)
    steps = [l.split(",") for l in path.read_text().splitlines() if l.startswith("# step,")]
    if not steps:
        cli_util.fail("No '# step' lines: not a drive_test.py log. Use pid_report.py.",
                      cli_util.EXIT_FAIL, as_json)
    pos = (df.enc_l + df.enc_r) / 2 / COUNTS_PER_REV        # wheel turns, forward +
    head = (df.enc_l - df.enc_r) / COUNTS_PER_REV           # left-minus-right turns (the heading)
    # Real yaw from the gyro, deg, right + (gz reads negative turning right; runs 189-190),
    # summed tick by tick: what the body really turned, wheel scrub or not.
    bias = [l for l in path.read_text().splitlines() if l.startswith("# gyro_bias_dps,")]
    bias_z = float(bias[0].split(",")[3]) if bias else 0.0
    yaw = (-(df.gz_raw / GYRO_LSB - bias_z) * df.t_us.diff().fillna(0) / 1e6).cumsum()
    rows_out, exact = [], []
    if not as_json:
        print(f"{'step':20s} {'asked':>11s} {'got spd':>7s} {'got trn':>7s} {'stop':>5s} {'head':>5s} "
              f"{'lean+':>5s} {'lean-':>5s} {'pwm':>4s} {'sat%':>4s} {'drop':>4s} flags")
    for i, (_, name, speed, turn, a, b) in enumerate(steps):
        speed, turn, a, b = float(speed), float(turn), int(a), int(b)
        g = df[(df.tick >= a) & (df.tick <= b)]
        if g.empty:
            continue
        lean = g.pitch - g.setpoint
        # Real speed over the last half of the step (after the ramp), turns/s, from the
        # encoder counts. Not from speed_l/speed_r: those read 3.3x low (CHANGELOG 2026-10-26)
        late = g.iloc[len(g) // 2:]
        secs = (late.t_us.iloc[-1] - late.t_us.iloc[0]) / 1e6 or 1
        got_s = (pos[late.index[-1]] - pos[late.index[0]]) / secs
        got_t = (head[late.index[-1]] - head[late.index[0]]) / secs
        # Stop: the furthest it rolled on (or kept turning) past where the command ended,
        # during the next pause, in turns. Driving: wheel turns; turning on the spot: heading.
        stop = turn_drift = np.nan
        if (speed or turn) and i + 1 < len(steps):
            nxt = df[(df.tick >= b) & (df.tick <= int(steps[i + 1][5]))]
            if not nxt.empty:
                track = pos if speed else head
                stop = ((track[nxt.index] - track[nxt.index[0]]) * np.sign(speed or turn)).max()
                turn_drift = head[nxt.index[-1]] - head[nxt.index[0]]
        # Heading: during a straight or still step, how much it turned anyway
        if not turn:
            turn_drift = head[g.index[-1]] - head[g.index[0]] if np.isnan(turn_drift) else turn_drift
        flags = int(np.bitwise_or.reduce(g.flag_bits.astype(int).values))
        # Seconds of a drive step with no command in force (Wi-Fi stall: the command ran out).
        # The first 0.25 s is skipped: the first command takes a moment to arrive.
        drop = ((g.iloc[50:].drive_speed == 0) & (g.iloc[50:].drive_turn == 0)).sum() / 200 if (speed or turn) else 0
        sat = 100 * ((g.flag_bits & FLAG_SAT) > 0).mean()
        pwm = g[["pwm_l", "pwm_r"]].abs().max().max()
        fault = bool(flags & FLAG_ENC_FAULT)
        deg = exact_deg(name)
        if deg is not None:
            # Exact spin: the angle the gyro saw from the request to the end of the next
            # pause (so the settle after landing counts), and how far off it is.
            drop = 0.0                 # the turn command goes to 0 on purpose while it lands
            end = int(steps[i + 1][5]) if i + 1 < len(steps) else b
            w = df[(df.tick >= a) & (df.tick <= end)]
            got_deg = yaw[w.index[-1]] - yaw[w.index[0]]
            landed = df[(df.tick >= a) & (df.tick <= b)]
            exact.append({"step": name, "deg": deg, "gyro_deg": _num(got_deg, 1), "error_deg": _num(got_deg - deg, 1),
                          "secs": _num((landed.t_us.iloc[-1] - landed.t_us.iloc[0]) / 1e6, 2)})
        rows_out.append({
            "step": name, "speed": speed, "turn": turn,
            "got_speed": _num(got_s), "got_turn": _num(got_t),
            "stop": _num(stop), "head": _num(turn_drift),
            "lean_max": _num(lean.max(), 1), "lean_min": _num(lean.min(), 1),
            "pwm": _num(pwm, 0), "sat_pct": _num(sat, 0), "drop_s": _num(drop, 1),
            "flags": flags, "encoder_fault": fault,
        })
        if not as_json:
            print(f"{name:20s} {speed:+5.2f} {turn:+5.2f} {got_s:+7.2f} {got_t:+7.2f} {stop:+5.2f} {turn_drift:+5.2f} "
                  f"{lean.max():5.1f} {lean.min():5.1f} {pwm:4.0f} "
                  f"{sat:4.0f} {drop:4.1f} {flags}"
                  + ("  ENCODER FAULT" if fault else ""))
    if as_json:
        header = [line[2:] for line in path.read_text().splitlines()
                  if line.startswith(("# drive_test,", "# gains_v"))]
        print(json.dumps({"ok": True, "file": str(path), "steps": rows_out, "exact": exact, "header": header}))
        return
    if exact:
        print("\nexact spins (gyro, deg, right +; from the request to the end of the next pause):")
        for e in exact:
            print(f"  {e['step']:14s} asked {e['deg']:+6.0f}  got {e['gyro_deg']:+7.1f}  error {e['error_deg']:+6.1f}  "
                  f"landed in {e['secs']:.2f} s")
    print("\nasked: speed, turn (turns/s). got: wheel average over the step's last half. "
          "stop: furthest it rolled (or turned) on after the command ended, turns (goal under 0.5). head: turns of "
          "left-minus-right drift after stopping, or during a still step (goal near 0). "
          "lean: max forward/back of pitch minus setpoint, deg. sat%: ticks at the PWM cap (flag 8). "
          "drop: seconds the command ran out mid-step (Wi-Fi stall): don't compare gains on a step with drops.")
    for line in path.read_text().splitlines():
        if line.startswith(("# drive_test,", "# gains_v")):
            print(line[2:])


def parser():
    ap = argparse.ArgumentParser(description=__doc__, formatter_class=argparse.RawDescriptionHelpFormatter)
    ap.add_argument("test", nargs="?", choices=list(TESTS), help="which test to run")
    ap.add_argument("--host", default=os.environ.get("BB1_HOST", "bb1.local"),
                    help="robot address, optionally with :port (default $BB1_HOST or bb1.local)")
    ap.add_argument("-n", "--note", default="", help="note saved in the file and its name")
    ap.add_argument("--surface", default="wood", help="what BB1 stands on (default wood)")
    ap.add_argument("-o", "--out", help="output file (default logs/bb1_<date>_<time>_<note>.csv)")
    ap.add_argument("--list", action="store_true", help="print the steps of every test")
    ap.add_argument("--report", metavar="LOG", help="report a saved drive_test.py log instead of running")
    cli_util.standard_cli(ap)
    return ap


def main(argv=None):
    global _JSON
    ap = parser()
    args = ap.parse_args(argv)
    _JSON = bool(args.json)
    if args.list:
        if args.json:
            tests = {k: [{"name": n, "speed": s, "turn": t, "secs": sec} for n, s, t, sec in steps]
                     for k, steps in TESTS.items()}
            print(json.dumps({"ok": True, "tests": tests}))
        else:
            for k, steps in TESTS.items():
                print(f"{k}: " + ", ".join(f"{n} {s:g}s" for n, _, _, s in steps))
        return
    if args.report:
        report(find_file(args.report), as_json=args.json)
        return
    if not args.test:
        ap.error("name a test (or --list)")
    name, _, port = args.host.partition(":")
    try:
        ip = socket.gethostbyname(name)       # look up bb1.local once: .local lookups can be slow
    except OSError:
        cli_util.fail(f"Can't find {name}. Try --host <ip> (type 'wifi' on serial).",
                      cli_util.EXIT_USAGE, args.json)
    path = run_test(f"http://{ip}{':' + port if port else ''}", args.test, args.note, args.surface, args.out)
    say()
    report(path, as_json=args.json)


if __name__ == "__main__":
    main()
