hectorsvill/bb1-balance-bot-1/tools/drive_explore.py

"""drive_explore.py - drive BB1 around a box for a long time, to collect training logs.

Usage (BB1 balancing in the middle of a clear box on the floor):
    tools/venv/bin/python tools/drive_explore.py --box 1.5 --minutes 60 --surface wood
    tools/venv/bin/python tools/drive_explore.py --box 1.5 --minutes 1 --host localhost:8080   # mock

Moves BB1. It picks random drive commands (straight, reverse, spin, arc,
stop) for 1-4 s each, plus with --exact-spins exact 90 and 360 deg spins
(POST /spin, firmware 3.10+), at most --max-speed, and keeps BB1 inside a square box
of --box metres around where it started: it tracks x, y and heading from the
encoders (odometry) and, near the edge, turns toward the middle and drives
back. Every command is a "# step" line in the log, like drive_test.py.

Safety (same commands as drive_test.py: 3 s each, re-sent every 100 ms, stopped after every move):
  - stops for good on a fall, an encoder fault, battery under --min-cell volts
    per cell, or BB1 past the box edge (odometry drifts: the box is shrunk to
    80% to leave room)
  - a Wi-Fi stall only pauses driving (BB1 stops by itself within 3 s); after
    30 s with no answer it gives up
  - Ctrl-C stops driving and saves

Saves a complete log file every --chunk minutes (logs/bb1_<time>_explore-pN.csv),
so a crash or a fall loses at most one chunk's tail.
"""

import argparse
import json
import math
import random
import socket
import sys
import time
from datetime import datetime

import cli_util
import drive_test
from drive_test import COUNTS_PER_REV, Run, Stop
from logger import get, log_path, save_log

WHEEL_TURN_M = 0.178   # metres per wheel turn: rolled one turn on the wood floor, 177.8 mm (we measured it 2026-10-26; = 56.6 mm wheel)
TRACK_M = 0.127        # metres between the tyre centres (measured 2026-10-26)
SAFE_BOX = 0.8         # use 80% of the box: odometry drifts


class Odometry:
    """x, y (metres, x = forward at the start) and heading (rad, + = left) from the encoders.
    Heading from BB1's gyro (/state yaw_deg, firmware 3.11+) when it has one: the
    wheels scrub in a spin and overcount the turn by about 20% (runs 189-190)."""

    def __init__(self, enc_l, enc_r, yaw_deg=None):
        self.x = self.y = self.th = 0.0
        self.l, self.r = enc_l, enc_r
        self.yaw0 = yaw_deg

    def update(self, enc_l, enc_r, yaw_deg=None):
        dl = (enc_l - self.l) / COUNTS_PER_REV * WHEEL_TURN_M
        dr = (enc_r - self.r) / COUNTS_PER_REV * WHEEL_TURN_M
        self.l, self.r = enc_l, enc_r
        d = (dl + dr) / 2
        if self.yaw0 is not None and yaw_deg is not None:
            self.th = -math.radians(yaw_deg - self.yaw0)   # gyro: yaw is right +, th is left +
        else:
            self.th += (dr - dl) / TRACK_M      # right wheel further = turned left
        self.x += d * math.cos(self.th)
        self.y += d * math.sin(self.th)

    def home_angle(self):
        """Angle to turn (rad, + = left) to face the middle of the box."""
        a = math.atan2(-self.y, -self.x) - self.th
        return math.atan2(math.sin(a), math.cos(a))


def pick_move(max_speed, exact_spins=False):
    """A random (name, speed, turn, seconds). turn + = right, like /drive.
    exact_spins: also "exact +90" / "exact -360" style steps (one POST /spin each:
    the name carries the angle, turn the rate, seconds the most it waits)."""
    s = round(random.uniform(0.15, max_speed), 2)
    t = round(random.uniform(0.2, 0.6), 2)
    kinds, weights = ["fwd", "back", "spin", "arc", "stop"], [3, 2, 2, 3, 2]
    if exact_spins:
        kinds, weights = kinds + ["exact"], weights + [3]
    kind = random.choices(kinds, weights=weights)[0]
    if kind == "exact":
        deg = random.choice([90, 90, 360]) * random.choice([-1, 1])
        rate = random.choice([2.0, 2.0, 4.0])
        return f"{drive_test.EXACT}{deg:+d}", 0.0, rate if deg > 0 else -rate, round(2 * abs(deg) / (rate * 66) + 2, 1)
    secs = round(random.uniform(1.0, 4.0), 1)
    if kind == "fwd":
        return f"fwd {s}", s, 0.0, secs
    if kind == "back":
        return f"back {s}", -s, 0.0, secs
    if kind == "spin":
        t *= random.choice([-1, 1])
        return f"spin {t:+}", 0.0, t, min(secs, 2.5)
    if kind == "arc":
        t *= random.choice([-1, 1])
        sign = random.choice([1, 1, -1])
        return f"arc {sign * s:+} {t:+}", sign * s, t, secs
    return "stop", 0.0, 0.0, secs


class Explorer:
    def __init__(self, base, args):
        self.base, self.args = base, args
        self.half = args.box / 2 * SAFE_BOX
        self.run = Run(base)
        self.steps = []                 # (name, speed, turn, from_tick, to_tick) for this chunk
        self.chunk = 1
        self.chunk_start = datetime.now()
        self.meta = get(f"{base}/log/meta")

    def _say(self, text):
        """Progress. With --json this goes to stderr so the final document is the only stdout."""
        print(text, file=sys.stderr if self.args.json else sys.stdout)

    def state(self):
        """/state, or None during a short Wi-Fi stall (ridden out like every other request:
        one slow answer while the Pico sends a slow /log ended a run after 18 s, 2026-10-26).
        Odometry loses nothing: it works from encoder counts, so the next answer catches up."""
        text = self.run.ask(get, f"{self.base}/state", timeout=1)
        if text is None:
            return None
        s = json.loads(text)
        self.odo.update(s["enc_l"], s["enc_r"], s.get("yaw_deg"))
        return s

    def save_chunk(self, why=""):
        r = self.run
        if not r.rows:
            return
        meta = self.meta + "".join(f"# step,{n},{s:.2f},{t:.2f},{a},{b}\n" for n, s, t, a, b in self.steps)
        meta += f"# drive_explore,box {self.args.box} m,max_speed {self.args.max_speed},chunk {self.chunk}{(',' + why) if why else ''}\n"
        note = f"{self.args.note} explore p{self.chunk}".strip()
        out = None
        if self.args.out_dir:            # e.g. a scratch folder for mock runs: mock data never goes in logs/
            out = f"{self.args.out_dir}/{log_path(note, self.chunk_start).name}"
        save_log(log_path(note, self.chunk_start, out), meta, note, self.chunk_start, r.header, r.rows, r.lost,
                 r.versions, self.args.surface, announce=not self.args.json)
        r.rows, r.lost, self.steps = [], 0, []
        self.chunk += 1
        self.chunk_start = datetime.now()
        self.meta = get(f"{self.base}/log/meta")      # fresh gains line for the next chunk

    def drive_for(self, name, speed, turn, secs):
        """Run one move. Returns when it's done or the edge is near (driving away from the middle)."""
        r = self.run
        start = r.tick
        deg = drive_test.exact_deg(name)
        if deg is not None:            # exact spin: BB1 lands on the angle by itself
            r.spin(deg, turn, secs)
            s = self.state()
            if s:
                self.watch(s)
            self.steps.append((name, speed, turn, start, r.tick))
            return
        end = time.time() + secs
        moving = speed or turn
        while time.time() < end:
            if moving:
                r.drive(speed, turn)
            r.check()
            r.record()
            if time.time() - getattr(self, "last_state", 0) > 0.25:   # 4 a second: keep the Pico's load like the page's
                self.last_state = time.time()
                s = self.state()
                if s:
                    self.watch(s)
            # Heading out of the box: cut the move short so the next one brings it back
            if moving and self.outside(0.9) and speed and math.cos(self.odo.home_angle()) * speed < 0:
                break
            time.sleep(drive_test.RESEND_S)
        if moving:
            r.stop()
        self.steps.append((name, speed, turn, start, r.tick))

    def outside(self, frac):
        return max(abs(self.odo.x), abs(self.odo.y)) > self.half * frac

    def watch(self, s):
        """Stop for good on anything that needs a person."""
        cell = s["batt_v"] / 2
        if s["batt_ok"] and cell < self.args.min_cell:
            raise Stop(f"battery {cell:.2f} V/cell, under {self.args.min_cell}")
        if max(abs(self.odo.x), abs(self.odo.y)) > self.args.box / 2:
            raise Stop(f"past the box edge (x {self.odo.x:+.2f} m, y {self.odo.y:+.2f} m)")

    def go_home(self):
        """Near the edge: turn to face the middle, then drive toward it."""
        a = self.odo.home_angle()
        if abs(a) > math.radians(25):
            # turn + = right = heading goes down; at about 0.4 turns/s difference that's
            # 0.4 * 0.178 / 0.127 = 0.56 rad/s, so spin about |a| / 0.56 seconds
            self.drive_for("home turn", 0.0, -0.4 if a > 0 else 0.4, min(3.0, abs(a) / 0.56))
        dist = math.hypot(self.odo.x, self.odo.y)
        self.drive_for("home fwd", 0.25, 0.0, min(4.0, dist / (0.25 * WHEEL_TURN_M)))

    def main(self):
        r = self.run
        r.check(force=True)             # refuses unless armed and no encoder fault
        s = json.loads(get(f"{self.base}/state"))
        self.odo = Odometry(s["enc_l"], s["enc_r"], s.get("yaw_deg"))
        t_end = time.time() + self.args.minutes * 60
        why = "done"
        self._say(f"Exploring a {self.args.box} m box for {self.args.minutes:g} min. Ctrl-C stops.")
        try:
            while time.time() < t_end:
                try:
                    if self.outside(0.7):
                        self.go_home()
                    else:
                        self.drive_for(*pick_move(self.args.max_speed, self.args.exact_spins))
                except Stop as e:
                    if "no answer" not in str(e):
                        raise
                    # Wi-Fi stall: BB1 has already stopped by itself. Wait and try again.
                    self._say(f"  {datetime.now():%H:%M:%S} Wi-Fi: {e}; waiting")
                    for _ in range(10):
                        time.sleep(3)
                        try:
                            r.check(force=True)
                            break
                        except Stop as e2:
                            if "no answer" not in str(e2):
                                raise
                    else:
                        raise Stop("no answer from BB1 for 30 s")
                if (datetime.now() - self.chunk_start).total_seconds() > self.args.chunk * 60:
                    self.save_chunk()
                if time.time() - getattr(self, "last_print", 0) > 30:
                    self.last_print = time.time()
                    self._say(f"  {datetime.now():%H:%M:%S} x {self.odo.x:+.2f} y {self.odo.y:+.2f} m, "
                               f"heading {math.degrees(self.odo.th) % 360:3.0f} deg, batt {s['batt_v'] / 2:.2f} V/cell")
                    s = json.loads(get(f"{self.base}/state"))
        except Stop as e:
            why = f"stopped: {e}"
        except KeyboardInterrupt:
            why = "stopped: Ctrl-C"
        except Exception as e:
            why = f"stopped: error {e!r}"
        finally:
            r.stop()
        self._say(f"  {why}")
        t = time.time() + 2               # 2 s more so a fall is in the file
        while time.time() < t:
            try:
                r.last_fetch = 0
                r.record()
            except Exception:
                pass
            time.sleep(0.25)
        self.save_chunk(why.replace(",", ";"))
        return why


def main():
    ap = argparse.ArgumentParser(description=__doc__, formatter_class=argparse.RawDescriptionHelpFormatter)
    ap.add_argument("--box", type=float, required=True, help="side of the clear square, metres")
    ap.add_argument("--minutes", type=float, default=60)
    ap.add_argument("--max-speed", type=float, default=0.4, help="turns/s (default 0.4)")
    ap.add_argument("--min-cell", type=float, default=3.5, help="stop under this many volts per cell")
    ap.add_argument("--chunk", type=float, default=5, help="save a log file every this many minutes")
    ap.add_argument("--host", default="bb1.local")
    ap.add_argument("--surface", default="wood")
    ap.add_argument("-n", "--note", default="", help="note in every chunk's file and name")
    ap.add_argument("--seed", type=int, help="random seed (to repeat a run)")
    ap.add_argument("--exact-spins", action="store_true", help="also exact 90 / 360 deg spins (POST /spin, firmware 3.10+)")
    ap.add_argument("--out-dir", help="save the chunks here instead of logs/ (use it for the mock)")
    cli_util.standard_cli(ap)
    args = ap.parse_args()
    random.seed(args.seed)
    drive_test.MAX_TRAVEL = 1e9          # the box check replaces drive_test's 3-turn limit
    name, _, port = args.host.partition(":")
    try:
        ip = socket.gethostbyname(name)
    except OSError:
        cli_util.fail(f"Can't find {name}. Try --host <ip>.", cli_util.EXIT_USAGE, args.json)
    try:
        why = Explorer(f"http://{ip}{':' + port if port else ''}", args).main()
    except Stop as e:
        cli_util.fail(f"Not starting: {e}", cli_util.EXIT_FAIL, args.json)
    if args.json:
        print(json.dumps({"ok": why == "done", "why": why}))
    # Same codes with or without --json: 0 finished the minutes, 1 stopped early, 130 Ctrl-C.
    if why == "stopped: Ctrl-C":
        raise SystemExit(cli_util.EXIT_INTERRUPT)
    if why != "done":
        raise SystemExit(cli_util.EXIT_FAIL)


if __name__ == "__main__":
    main()
