hectorsvill/bb1-balance-bot-1/tools/pid_report.py

"""pid_report.py - read a balance log and say how each try went.

Usage:
    tools/venv/bin/python tools/pid_report.py logs/bb1_2026-10-23_...csv
    tools/venv/bin/python tools/pid_report.py logs/bb1_...csv --plot      # also draw each try
    tools/venv/bin/python tools/pid_report.py                             # newest file in logs/

One row per try (each time it was armed), then hints. The hints say which
term looks too big or too small, never a number: you pick the gains.

What the columns mean (all from the armed part of the try only):
    secs     how long it stayed armed (10 = the arm timer ran out, it never fell)
    end      timer / FELL fwd / FELL back / you (STOP, Enter) / Wi-Fi lost (no /state
             for 2 s while armed over Wi-Fi) / tab hidden / IMU error / loop late
             / picked up / battery (under 3.3 V per cell, sense wire present)
    wobble   standard deviation of the error, deg. Smaller = calmer
    lean     average error, deg. Far from 0 = trim is off (+ = leans forward)
    |P| |I| |D|  average size of each term, in PWM. Who is doing the work?
    cap%     share of ticks where the output hit the cap (motors maxed out)
    flips/s  how often the PWM changes sign. Tens per second = jitter (D)
    turns    wheel turns from start to end (+ = rolled forward)
    V/cell   lowest battery voltage per cell during the try (logs from 2026-10-24 on)
"""

import argparse
import json

import cli_util
from pathlib import Path

import numpy as np
import pandas as pd

from check_dump import find_file, load_dump
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
