hectorsvill/bb1-balance-bot-1/(commit log)

2026-10-21 Initial commit: Milestone 1 CAD, bring-up firmware and docs
    [carrier_d153c_m25.stl, carrier_pico_sideways_m2.stl, chassis_bottom_plate.scad, chassis_bottom_plate.stl, hcsr04_holder.stl, reverse_t_frame_short.stl, robot_platform.scad]
2026-10-21 Add firmware plan and PID tuning guide
2026-10-21 bb1 step 1: gyro bias calibration and complementary filter pitch
2026-10-21 bb1: forward lean reads positive without negation; fix sign notes
    [config.h]
2026-10-21 Docs: calibration and reading logs; add summarize_serial.py
2026-10-21 bb1 step 4: log download, live log view, memory panel, offline mock
    - /log?since=N, /log/meta, /sys endpoints; log_meta.h shared settings lines
    - page: Record/Stop/Download, Save last 10 s, Live log, Pico memory,
    one column of reorderable panels, wide content scrolls inside its panel
    - calibration retries at startup until the robot is still (flag bit 4)
    - tools/logger.py, tools/mock_bb1.py; check_dump.py reads every log source
    - docs: saving logs, offline mock, battery care, FUTURE_INTEGRATIONS.md
    - uf2 rebuilt (not yet tested on the robot)
2026-10-21 bb1 step 5: motors + encoders, timed motor test
    - motors.h: TB6612 driver, encoder interrupts on core 1, wheel speed
    - motor test from serial (m L R ms), the page and POST /motor; capped at
    PWM 150 and 3 s, stops by itself; STOP button and space bar
    - log format 2: enc_l, enc_r, speed_l, speed_r, pwm_l, pwm_r
    - check_dump.py wheel summary and plot; mock fakes the motors
    - logging self-check on the robot: 4254 records, 0 missing, 0 lost
    [bb1.ino, check_dump.py, config.h, log_meta.h, logger.py, mock_bb1.py, motors.h, page.h]
2026-10-21 bb1 step 6: arm / disarm, safety checks, angle PD loop
    - pid.h, control.h: disarmed / armed / fallen; arm only near upright and
    calibrated; auto-disarm on fall, IMU errors, overruns, lost page
    - live gains, trim, cap, deadband from serial and the page Balance panel
    - log format 3: setpoint, p/i/d terms, gains_ver; mode 4 armed, 5 fallen
    - mock arms too; self-check disarmed on the robot: 0 lost, 0 missing
    [bb1.ino, config.h, control.h, log_meta.h, mock_bb1.py, page.h, pid.h, shared.h]
2026-10-21 bb1 step 6: log the disarm reason every tick, disarm when the page is hidden
    First hand-held arm drove the wheels the right way but stopped after
    1.2 s with no recorded cause; the reason column makes that visible.
2026-10-21 bb1 step 6: fix early heartbeat disarms, arm timer, one Log panel, clearer Apply
    - Wi-Fi power save made /state wait up to 1.2 s; noLowPowerMode on the
    home network (max 600 ms now); race-proof heartbeat compare; page
    request timeout; web_age_ms logged every tick (log format 5)
    - ARM for N s (page box, serial arm N, /arm seconds=)
    - Record shows the records as they arrive (Log and Live log combined)
    - changed gain boxes turn orange, Apply says Apply changes, Enter applies
    - hints included in this flash
    [bb1.ino, control.h, log_meta.h, mock_bb1.py, page.h, shared.h, telemetry.h, web.h]
2026-10-21 page redesign: status bar with countdown and STOP, PID panel, log table
    - always-visible status bar: connection, mode, arm countdown, STOP
    - Balance: big countdown + progress bar, gain fields with units
    - new view-only PID panel: tiles and a 10 s chart of P, I, D, output, cap
    - Log: table with sticky header, armed rows tinted, short/all columns
    - tiles instead of tables, foldable panels, hover hints, phone layout
    - /state arm_left_ms (shared armedSinceMs); mock updated
    [control.h, mock_bb1.py, page.h, shared.h, web.h]
2026-10-21 bb1 step 7: save balance settings in flash, step test
    - settings.h: gains, trim, cap, deadband saved next to the Wi-Fi settings,
    loaded at startup; save / defaults from serial, page and HTTP
    - step test: setpoint +2 deg for 1 s while armed
    - defaults trim -4.39, cap 80
    - verified: survives a restart, flash write caused no missed ticks
    [bb1.ino, config.h, control.h, mock_bb1.py, page.h, settings.h, shared.h, web.h]
2026-10-22 build record: battery placement from Hector's photos
2026-10-22 web: close each connection after answering (fixes heartbeat disarms)
    The WebServer library waits up to 5 s for the browser to close a served
    connection and serves nothing else meanwhile, so /state stalled and armed
    runs disarmed with "lost the web page".
    [web.h]
2026-10-22 docs: hand-held test uses quiet, Arduino IDE monitor option
2026-10-22 tools: handheld.py, the arm test in one window
    Keys arm (5 s), disarm and save; serial readout folded into a status line;
    the log is recorded over Wi-Fi with logger.py's code.
2026-10-22 docs: hand-held arm test result (directions correct)
2026-10-22 docs: fall cut-out checked, hand-held test passed
2026-10-22 docs: floor run 4 (cap 150, 7.2 s), Hector tunes the PID from here
2026-10-22 Tuning page at /tune; page gain changes print on serial and go in handheld logs
2026-10-22 docs: floor run 5 (P10 D5): D-driven jitter
2026-10-23 find_port: pick the Pico by USB vendor ID, not the first usbmodem
2026-10-23 docs: STBY wire came unsoldered
2026-10-23 Wiring diagram image (docs/wiring.svg/png) drawn from the pin tables
2026-10-23 FLASHING.md: Arduino IDE steps, serial monitor blocks upload, settings survive reflash
2026-10-23 pid_report.py, tune page log section, PID lesson and learning prompt
2026-10-23 handheld.py --wifi: tune with no USB cable
2026-10-23 tune page: ARM with timer and STOP, for runs without USB
2026-10-23 docs/TUNING_LOG.md (round 10, no cable); pid_report names disarm reasons
2026-10-24 TUNING_LOG round 12 (trim +6.1); pid_report trim hint direction fixed
    [pid_report.py]
2026-10-24 tools/deadband_test.py: find the PWM where the wheels start turning
2026-10-24 Deadband measured: wheels start at PWM 10-15 in the air, about 30 on wood
    [deadband_2026-10-23_21-37-35.csv]
2026-10-24 Keep logs/ out of git (as before)
    [deadband_2026-10-23_21-37-35.csv]
2026-10-24 docs: motor kit reference (D153C battery pin), fix 3 doc mismatches, ignore graphify-out
2026-10-24 Battery voltage: D153C ADC pin on GP26, read on core 0, shown on both pages, logged as batt_v (log format 6)
2026-10-24 battery: discard first ADC samples after power-up; flashed with clean-up and 2 s heartbeat
2026-10-24 Battery: calibrated to the meter (12.07), shown per cell
2026-10-24 docs: battery calibration and per-cell display
2026-10-24 docs: battery per-cell build flashed
2026-10-24 BUILD_RECORD: battery wire fitted and calibrated
2026-10-24 deadband_test: save PWM frequency and battery in the results
2026-10-24 BUILD_RECORD: 20 vs 10 kHz PWM deadband comparison
2026-10-24 PWM 10 kHz kept (lower deadband)
2026-10-24 TUNING_LOG round 22: motors act as speed knobs, angle I term needed
2026-10-24 Auto-arm when stood upright; GitHub-ready clean-up (README, placeholder AP password, no home paths, rebuilt UF2)
2026-10-24 Auto-arm flashed
2026-10-24 SESSION_LOG: wrap-up, open items for the next thread
2026-10-24 Power-on behavior: auto_arm.h state machine, lift detector, fall limit, POWER_ON.md
2026-10-24 Power-on rework flashed
2026-10-24 Main page clean-up: status + ARM/STOP, dev panels folded; handheld.py is testing only
2026-10-24 Fix: balance after switching on upright (start with the typical gyro bias)
    [auto_arm.h, bb1.ino, config.h, control.h, imu.h, log_meta.h, mock_bb1.py, shared.h]
2026-10-25 Stub narrative docs and compile firmware/bb1 in CI. (#1)
    Point session, tuning, build record, PID lesson, learning prompt, and future-parts write-ups at the second brain, and keep those filenames plus the pin table. Delete the orphan tools/step1.txt dump. Add an arduino-cli workflow for the Pico W sketch.
2026-10-25 Disarm while armed when the battery is under 6.6 V (#2)
    A low pack only blocked auto-arm. Once balancing, the motors could keep
    driving as the voltage sagged. balanceTick now cuts out with REASON_BATTERY
    using the same batteryTooLow() check as auto-arm (no sense wire still
    allowed), and balanceArm refuses for the same reason.
    [auto_arm.h, battery.h, bb1.ino, config.h, control.h, mock_bb1.py, pid_report.py]
2026-10-25 Docs: auto-arm state list after the typical-bias fix (NO_IMU, log format 8)
2026-10-25 Power-on work done: flashed and working
2026-10-25 Power-on: docs match the flashed firmware (#3)
    * Docs: auto-arm state list after the typical-bias fix (NO_IMU, log format 8)
    * Power-on work done: flashed and working
    ---------
2026-10-25 Milestone 2: drive BB1 from the web page, and document the HTTP API
    - drive.h: POST /drive (speed, turn in wheel turns/s) moves the speed loop
    and heading hold targets, with ramps and turn feedforward. Each command
    lasts 500 ms (ms= up to 3 s): not re-sent = ramp to a stop, keep balancing.
    - POST /drive/stop, serial "drive S T [ms]" / "drive stop", /state "drive".
    - Main page: Drive panel with a joystick pad, arrow keys / WASD, max speed
    slider and hover hints. mock_bb1.py answers the new endpoints.
    - Logs: format 9 adds drive_speed, drive_turn (operator command), flag 16.
    - docs/API.md: full HTTP reference + what the AI-agent milestone still needs.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
2026-10-25 Drive feedforward (dff): stop backward falls when reversing
    The first drive log showed every fall happened on a reverse or stop: the
    angle I term held ~100 PWM to keep 1 turn/s and had to unwind before the
    wheels could reverse, so BB1 tipped back and hit the cap. dff adds PWM per
    turn/s of speed target straight to the wheels. Live setting on /tune and
    serial, saved in flash (settings v5), default 60.
    Claude-Session: https://claude.ai/code/session_01KsCGct25fzKLxXdoPPThPc
    [bb1.ino, config.h, control.h, log_meta.h, logger.py, mock_bb1.py, settings.h, shared.h]
2026-10-25 Drive: hold where it stops, no catch-up after letting go
    Floor test 2: after driving BB1 kept rolling 2-4 wheel turns and swung
    35-90 deg when left alone, catching up position and heading targets that
    were allowed a full wheel turn of lag. Now the position target rides with
    the wheels while driving, the heading target stays within 0.25 turns, and
    both snap to where BB1 is the moment it comes to a stop.
    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
    [config.h, drive.h]
2026-10-25 Encoder fault detector: heading hold off instead of circling
    The drive logs show the left encoder reading 0 whenever the wheels roll
    backward (a loose wire), which made the heading hold spin BB1 in circles
    and the speed loop under-brake in reverse. Going straight, one wheel under
    20% of the other's speed for 0.3 s now sets enc_fault: heading hold off,
    /drive refused, log flag 32, warning on the page.
    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
    [bb1.ino, config.h, control.h, mock_bb1.py, page.h, shared.h, telemetry.h, web.h]
2026-10-26 Drive tests, drive tuning findings, turning fix, training dataset
    - tools/drive_test.py: named drive tests over Wi-Fi with # step lines and a
    per-step report; refuses unless armed with no encoder fault, 1 s commands,
    /drive/stop on any error, 3-turn travel limit
    - Firmware (not flashed): DRIVE_TURN_FF 15 -> 45, TURN_HOLD_MAX_PWM 60,
    per-axis drive holds (turning keeps position hold; straight keeps full
    heading hold), encoder fault ends the running command, one driveCommand()
    clamp for HTTP and serial that refuses nan, static_assert on the int8 log
    fields, arrow keys scroll unless balancing
    - Tools: shared GAIN_KEYS (dff reaches handheld.py logs), mock drive command
    cleared on a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
    [bb1.ino, config.h, control.h, dataset.py, drive.h, drive_test.py, handheld.py, logger.py]
2026-10-26 Wheel speed reads 3.3x low: correct the drive findings, DRIVE_TURN_FF back to 15
    drive_test.py's report now takes speed from encoder counts.
    [config.h, drive_test.py]
2026-10-26 Fix wheel speed reading 3.3x low: constrain() macro ran update() 3 times a tick
    Scale-dependent settings changed so behavior stays the same: speed P
    default 4 -> 1.2, ENC_FAULT_MIN_SPEED 150 -> 500, dff default 60 -> 25.
    The lift detector is now really at 4 turns/s (it could never trip).
    Log format 10; dataset.py rescales older speeds by 10/3.
    [bb1.ino, config.h, dataset.py, log_meta.h, mock_bb1.py]
2026-10-26 Drive speed I (sdi): stop forward driving getting stuck short of the asked speed
    [bb1.ino, config.h, control.h, drive.h, log_meta.h, logger.py, mock_bb1.py, settings.h]
2026-10-27 Wheel speed loop (smode 1: wsp/wsi straight to PWM) and log format 11
    smode 0 (default) keeps today's behavior. Log format 11 adds
    drive_speed_now, drive_turn_now and speed_pwm in spare padding bytes.
2026-10-27 bb1.py: wait for the wheels to stop, report turned_turns and settled; first run on BB1
2026-10-27 Measured wheel turn 177.8 mm in tools and docs
2026-10-27 Wheel turn 177.8 mm: homing spin time, CHANGELOG, CLAUDE.md
2026-10-27 Track width 127 mm; bb1.py turned_turns was halved (now matches drive.h)
2026-10-27 drive_explore: the position poll rides out Wi-Fi stalls (one slow /state ended a run)
    [drive_explore.py]
2026-10-27 Firmware updates over Wi-Fi (OTA): POST /update, flash.py --ota, 1 MB/1 MB flash split
    ota.h takes a new firmware into LittleFS with arduino-pico's Updater; the
    core's OTA bootloader copies it in on restart. Refused while armed, during
    a motor test or unless lying down; otaActive keeps core 1 from arming and
    core 1 confirms the motors are off before flash writes (they pause it).
    Password BB1_OTA_PASSWORD in secrets.h. /sys gains fs_total and build.
    flash.py, CI and FLASHING.md use FQBN :flash=2097152_1048576; ota.h fails
    the compile with any other layout. Not flashed yet.
    [api.h, bb1.ino, control.h, dataset.py, flash.py, mock_bb1.py, ota.h, secrets.example.h]
2026-10-27 Firmware version and build id (3.2); flash.py records every flash
    flash.py writes a gitignored build_id.h before each compile, so the
    sketch always recompiles (a cached compile kept the old __TIME__ and made
    the first OTA look failed) and BB1 reports exactly which build it runs:
    /sys, /api (API_VERSION 3), the main page and every log file.
    logs/flash_history.csv gets one line per flash.
    [api.h, flash.py, log_meta.h, mock_bb1.py, page.h, version.h, web.h]
2026-10-28 1N5819 diode fitted: power rule gone; battery sense shown as wired
    Docs, sketch comments and the wiring diagram (now with the GP26 battery wire)
    say USB and the battery can go on in any order. Battery care reflects the
    GP26 reading and the 6.6 V cut-out.
2026-10-28 docs/AGENT.md: the manual an AI agent drives BB1 from; CI keeps it current
    Settings the owner edits at the top, units, bb1.py commands, every state
    field and disarm reason, how to drive in small steps, safety rules, and what
    an agent must never touch. bb1.py api (new) prints /api; check_agent_doc.py
    fails CI when API_VERSION and AGENT.md's version line differ. CLAUDE.md says
    when to update it; milestones 3 and 4 named.
    [api.h, bb1.py, check_agent_doc.py]
2026-10-28 tools/runs_db.py: a SQLite catalog of every run (logs/runs.sqlite)
    One row per log (label, surface, firmware, starting gains as columns,
    duration, armed and drive time, disarms, pitch error, battery, outcome) and
    one per disarm. Incremental build, SQL queries and named ones (recent,
    longest, falls, by-gains). Reuses dataset.py and check_dump.py parsing; the
    CSVs stay the source of truth and the DB is never committed.
    [runs_db.py]
2026-10-28 bb1.py: record every command in logs/agent_commands.csv; refuse empty drives
    One CSV row per call against the real robot (time, host, cmd, args, exit
    code, answer); mock hosts are skipped and a failed write never breaks the
    command. drive refuses speed 0 + turn 0 and lists what it cut (--for past
    10 s, speeds past --max). Carpet results from a live test in AGENT.md and
    TOOLS.md; API.md no longer lists the wheel/track measurements as to do.
    [bb1.py]
2026-10-28 runs_db.py schema 2: all data in SQLite (ticks, steps, gains, meta, flashes, bb1.py commands)
    Each table is shaped for its use and joins to runs by run_id. Ticks carry
    t_s and wheel speed/turn in turns/s with the pre-format-10 scale fixed.
    The catalog now lives in the --logs folder it was built from.
    [runs_db.py]
2026-10-28 One store for all logs: recorders catalog into runs.sqlite; tools/logs.py reads it
    logger.save_log (logger, handheld, drive_test, drive_explore) adds each
    new log to logs/runs.sqlite right after saving the CSV. tools/logs.py is
    a read-only viewer with JSON out for AI agents (schema, runs, show,
    ticks, download, sql) and serve, a local page to filter, plot and
    download runs over the same JSON API.
2026-10-29 Firmware 3.3: log buffer stores no tick number (8 KB more RAM)
    Record n in the ring buffer is always tick n, so logGet() writes it back
    instead of storing it: 76 -> 72 bytes a record, static RAM 225,960 ->
    217,960 bytes. Same 10 s history, same CSV and endpoints. RAM breakdown,
    the LOG_SECONDS trade-off and the /log stall analysis in CHANGELOG and
    firmware/README.md.
    [log_meta.h, mock_bb1.py, telemetry.h, version.h, web.h]
2026-10-29 CI tests the Python tools; MCP server tools/bb1_mcp.py
    - tools/tests/test_tools.py (stdlib unittest): compiles every tools/*.py,
    builds runs.sqlite from tiny committed fixtures (60 real ticks each),
    checks logs.py JSON and write refusals, runs bb1.py against mock_bb1.py,
    and the MCP server in memory and over stdio
    - .github/workflows/tools.yml runs it on Python 3.9 and 3.12
    - tools/bb1_mcp.py (mcp 2.x MCPServer): bb1_* and logs_* tools that call
    bb1.run() and logs.py, so safety checks and the command log stay in one place
    - bb1.py: run(argv), drive --max-turn and --max-for; logs.py: --db
    - Docs: TOOLS.md, tools/README.md, AGENT.md, API.md, CHANGELOG, CLAUDE.md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
    [agent_commands.csv, bb1_2026-10-25_13-55-38_ci-wood-fall.csv, bb1_2026-10-28_09-52-44_ci-carpet-drive.csv, flash_history.csv]
2026-10-29 Fast drive step 1: aff, dacc, lmax live settings (firmware 3.4)
    Acceleration lean feedforward (aff), drive speed ramp (dacc, replaces
    DRIVE_ACCEL) and lean limit while driving (lmax, eases back to 6 deg at
    10 deg/s after a stop). Defaults = old behavior. Settings layout v9,
    API_VERSION 4, /state buffer 1536, runs_db schema 3. Step 2 plan
    (raise DRIVE_MAX_SPEED) in FIRMWARE_PLAN.md.
    [api.h, bb1.ino, config.h, control.h, drive.h, log_meta.h, logger.py, mock_bb1.py]
2026-10-29 No logs in the public repo: tests make up their own, *.csv gitignored
    [agent_commands.csv, bb1_2026-10-25_13-55-38_ci-wood-fall.csv, bb1_2026-10-28_09-52-44_ci-carpet-drive.csv, flash_history.csv]
2026-10-29 Firmware 3.5: trim learn (tl) fixes the backward creep after stops
    The speed loop's position hold point (drive.pos) is reset at every stop,
    so a trim error (+1.3 deg on wood) came back as a 0.2-0.4 turns/s
    backward creep after each command. tl is a position I term that is never
    reset: standing still, each wheel turn rolled moves the lean target tl deg
    the other way (balance.trimLearned, clamped to 3 deg, cleared at boot or
    tl 0). Default 1.0. /state trim_learned, gains tl, API 5, settings v10.
    Also: runs_db.catalog() rebuilds from every log when the schema version
    changed instead of leaving a 1-run catalog (SCHEMA_VERSION 4, new test).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
    [api.h, bb1.ino, bb1.py, config.h, control.h, log_meta.h, logger.py, mock_bb1.py]
2026-10-29 Firmware 3.6: fast drive step 2, top speed 3.0 turns/s
    - DRIVE_MAX_SPEED 1.0 -> 3.0 (turn stays 1.0)
    - Log format 12: drive_ fields int8 in 1/40 turns/s (max 3.17, no RAM cost);
    CSV still turns/s; flag 8 also counts PID + feedforward at the cap
    - Lift detector compares each wheel with its drive target
    - Speed guards: dff x speed <= cap - DRIVE_PWM_RESERVE, and back off after
    0.2 s at the cap while driving
    - Slowing down never slower than DRIVE_STOP_ACCEL_MIN (3 turns/s^2)
    - /api 6, AGENT.md, API.md, mock, page Max speed slider in turns/s (default 1.0),
    drive_test fwd-back-100..300, format-12 test, docs
2026-10-31 Firmware 3.7: fast spins (turn 5.0), deadband per wheel fixes turn jitter
    [angle.h, api.h, bb1.ino, config.h, control.h, drive_test.py, log_meta.h, mock_bb1.py]
2026-10-31 3.7: correct the gyro's yaw-to-pitch cross-talk and the spin's pull on the accelerometer (run 181)
    [angle.h, config.h]
2026-10-31 3.7: drop the centripetal accel correction and gyro-only spin mode (long left spins fell, run 186)
    [angle.h, config.h]
2026-11-02 3.8: refuse Wi-Fi save/forget/reset while armed (fixes #16)
    POST /wifi, POST /wifi/forget and serial 'wifi reset' wrote flash and
    restarted with no armed check. Now refused while armed or in a motor test
    (409 / serial message), like Save gains and OTA. The delayed restart also
    disarms first if auto-arm started balancing in the meantime.
    /api version 8; AGENT.md, API.md, mock, CHANGELOG updated.
    [api.h, bb1.ino, mock_bb1.py, version.h, web.h, wifi_setup.h]
2026-11-02 Make flash.py plan-only and tidy the Python tools.
    flash.py prints a JSON plan and exits 0 unless --execute is passed.
    --force still skips the lying-down check, but only together with --execute,
    and the plan warns when that check would be skipped. deadband_test.py
    exits instead of waiting on a prompt when stdin is not a terminal.
    Tools share --json and exit codes, ruff and Dependabot run in CI, and a
    v* tag builds the UF2 and uploads it to the GitHub Release.
    [bb1.py, bb1_mcp.py, check_agent_doc.py, check_dump.py, cli_util.py, dataset.py, deadband_test.py, drive_explore.py]
2026-11-03 3.9: clear a stuck I2C bus and retry the IMU at startup
    A software restart (OTA, Wi-Fi save) resets the Pico but not the
    MPU-6050; caught mid-read, the chip holds SDA low and WHO_AM_I fails
    until a power cycle (seen 2026-10-31 and 2026-11-02). imuBegin() now
    clocks SCL until SDA is free and sends a STOP, then tries WHO_AM_I up to
    3 times with a chip reset between. New header line # imu_start.
    [bb1.ino, imu.h, log_meta.h, mock_bb1.py, version.h]
2026-11-03 3.10: exact-angle spins (POST /spin), counted by the gyro
    Spins held their rate but landed at 334-398 deg for 360 (runs 189-190):
    the Mac's step timing over Wi-Fi ran 0.2-0.45 s late, and the wheels
    scrub (gyro yaw = 0.83 of the encoders'). Core 1 now counts the angle
    with the gyro and starts the turn ramp-down when the angle left equals
    the stopping angle. POST /spin deg rate, serial spin, page Spin buttons,
    /state drive.spin_left, log format 14 (spin_left in a padding gap: record
    stays 72 bytes), /api 9, drive_test exact-200/400 with a gyro report.
2026-11-03 3.11: spin settle, gyro heading in /state, bb1.py spin
    - drive.h: after a spin lands, a 1 s P correction on the gyro angle
    takes out the coast (0-10 deg in runs 193-194)
    - angle.h yaw (gyro heading since power-on), /state yaw_deg, /api 10
    - SPIN_MIN_RATE 0.5 -> 0.3 so AGENT.md's turn cap (0.4) can spin
    - bb1.py spin --deg (caps, safety checks, answers turned_deg from the
    gyro), drive answers turned_deg; MCP bb1_spin; tests; AGENT.md, API.md,
    TOOLS.md, CHANGELOG
    [angle.h, api.h, bb1.ino, bb1.py, bb1_mcp.py, config.h, drive.h, log_meta.h]
2026-11-03 bb1.py spin: only list --rate in cut when it was asked for
2026-11-03 tof_test: VL53L0X bring-up sketch on I2C1 (GP6/GP7)
    Scans I2C1, starts the VL53L0X (Pololu library 1.3.1), prints distance,
    closest and farthest about 20 times a second; motor driver kept asleep.
    Pin table: VL53L0X on I2C1 shared with the future OLED; HC-SR04 replaced.
    [tof_test.ino]
2026-11-03 drive_explore: --exact-spins (random exact 90/360 spins), heading from the gyro
